superhasduper/ca-on-electromagnetico/README.md

# ca-on-electromagnetico
Este trabajo es para la asignatura de física Electromagnética, es el trabajo de el grupo HEM, en este trabajo se ha trabajado como iguales. Los miembros del equipo somos Erik Lesta Lopez, Hector Avila Sanchez y Michele Ambrosini.
los archivos pdf resumen todo al completo
