superhasduper/ca-on-electromagnetico/Arduino y CAD/arduino y CAD.pdf

## Código de Arduino y archivos CAD:

Para tener un producto final más pulido programamos la placa y los sensores en Arduino (el archivo utilizado para disparar en las pruebas fue el de test2.ino el cual no utiliza los sensores y solo manda una señal a los optoacopladores para disparar, el programa de velocidad proyectil si que emplea los sensores)
Además, diseñamos en 3d usando solidworks, soportes para los sensores y el proyectil. Todos los archivos se encuentran en su carpeta correspondiente.

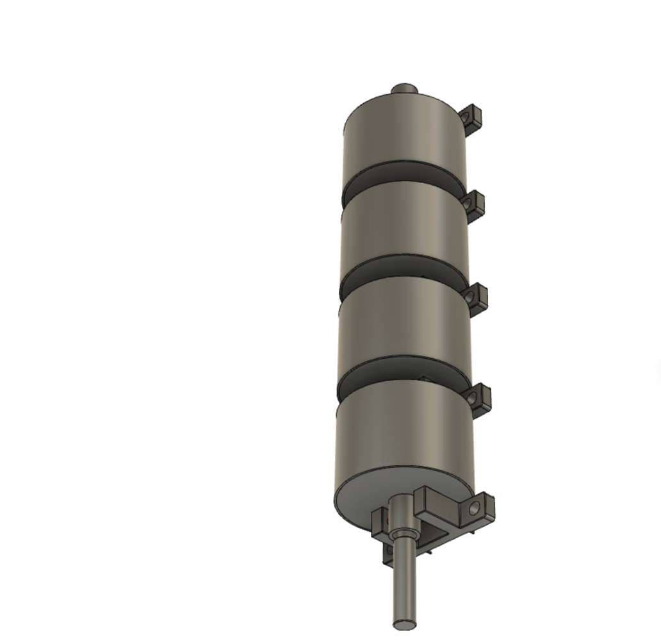
[picture p1: figure]

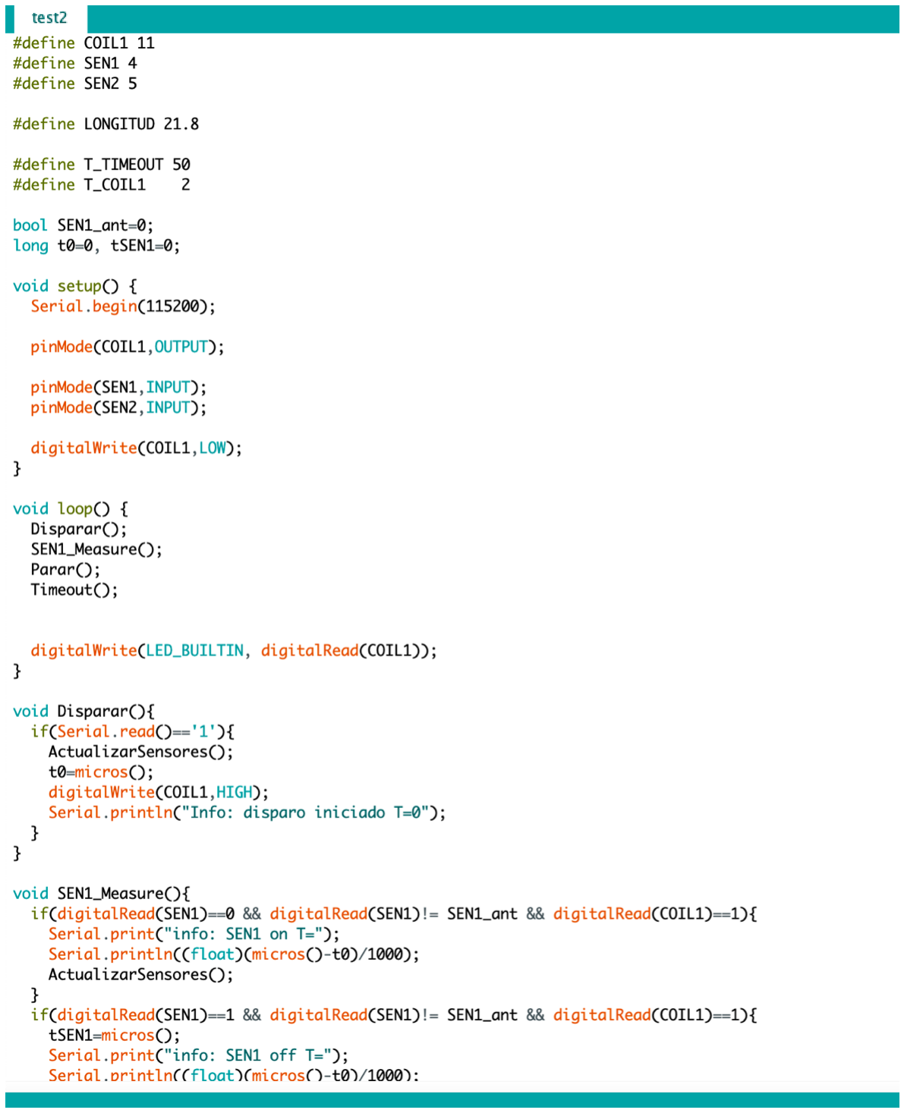
[picture p2: figure]
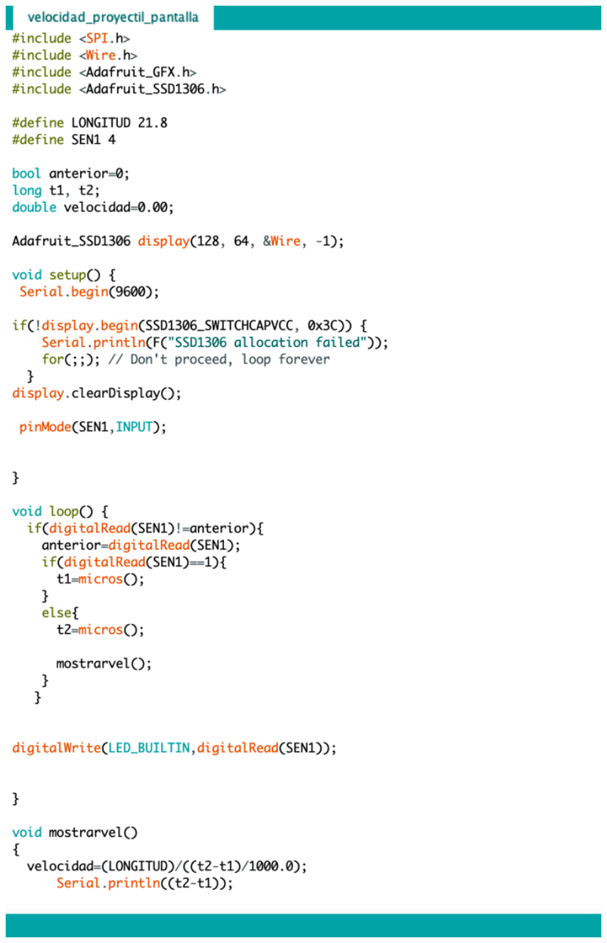
[picture p3: page 3]
