superhasduper/ca-on-electromagnetico/Cálculos y gráficas de simulaciones/Cálculo de velocidad del proyectil.pdf

Cálculo teórico de la velocidad de salida del proyectil

Si asumimos que la bobina que hemos utilizado para el cañón es “larga y estrecha”,

para calcular la velocidad del proyectil en el momento de salida, podemos computar

el cálculo de la inductancia de la misma, luego utilizar ese resultado para calcular el

trabajo (energía almacenada en la bobina) y finalmente, mediante la ley de

conservación de energía, relacionarlo con la velocidad de salida del proyectil:

Se puede probar que:

[1]

W =

1
2

⋅ L ⋅ i

2

Donde W es el trabajo realizado, L es la inductancia de la bobina, y i es la intensidad

de corriente.

Para calcular la inductancia L, y aceptando que se dispone de un solenoide ideal,

partimos del campo magnético de este:
B = μ0

⋅ n ⋅ i

Podemos calcular que el flujo en todo el solenoide será: φ = ∫B ⋅ dS =

S

μ0

⋅ n ⋅ i ⋅ S ⋅ N = μ0

⋅

N
l

⋅ i ⋅ S ⋅ N

Donde n =

número de vueltas
longitud bobina

=

N
l

, y S = superficie de sección transversal

Luego, se calculará la inductancia:

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
Sustituyendo [2] en [1]:

W =

1
2

⋅

μ0

⋅ N

2
⋅ S ⋅ i

2
l

(J)

Sustituyendo los datos calculados: μ0 = 4π ⋅ 10⁻⁷Wb/(A ⋅ m)

N = número de vueltas = 167
r = radio sección transveral = 5 ⋅ 10⁻³m

i = 5A
l = longitud bobina = 30 ⋅ 10⁻³m

W =

1
2

⋅

167²

⋅ π(5 ⋅ 10⁻³m)

2

⋅ 4π ⋅ 10⁻⁷ Wb
A ⋅ m

⋅ 5

2
30 ⋅ 10⁻³m

= 1.1469 ⋅ 10⁻³
J

Mediante la ley de conservación de energía y haciendo W = Em1
. Definimos el

momento (1) como un instante antes de que el proyectil sea expulsado de la bobina,

y el momento (2) como el instante en el que el proyectil es expulsado de la bobina.

Em1 + Ek1 = Em2 + Ek2

1.1469 J =

1
2

⋅ m ⋅ v

2

Sabiendo que m = masa proyectil = 3.6 ⋅ 10⁻³kg

v = √
2 ⋅ 1.1469 ⋅ 10⁻³ J
3.6 ⋅ 10⁻³kg = 0.7892 m/s
