superhasduper/ca-on-electromagnetico/Cálculos y gráficas de simulaciones/Gráficas de estadísticas recuperadas en simulaciones de rendimiento del cañón de bobina.pdf

- 1 -

Gráficas de estadísticas recuperadas en simulaciones de rendimiento del

cañón de bobina

Antes de acudir al laboratorio a probar el cañón, se le hicieron diferentes ensayos para medir

su rendimiento. En este documento se muestran los resultados que se obtuvieron mediante

gráficas.

Gráficos 1-11: Velocidad del proyectil en función del tiempo dentro de la bobina

Bobina sin carcasa metálica exterior

Alimentación por fuente de alimentación 10 A

En estos gráficos (titulados G:n en relación con el número de gráfico que se explica), se muestra

la velocidad (m/s) que se imprime en cada proyectil dependiendo del tiempo de simulación (ms)

(tiempo en el que el proyectil avanza cierta distancia dentro de la bobina). Se han analizado 11

proyectiles distintos, que varían desde 10mm hasta 20mm, con una diferencia de 1mm por

proyectil.

Resistencia: constante y de 0.41 ohm.

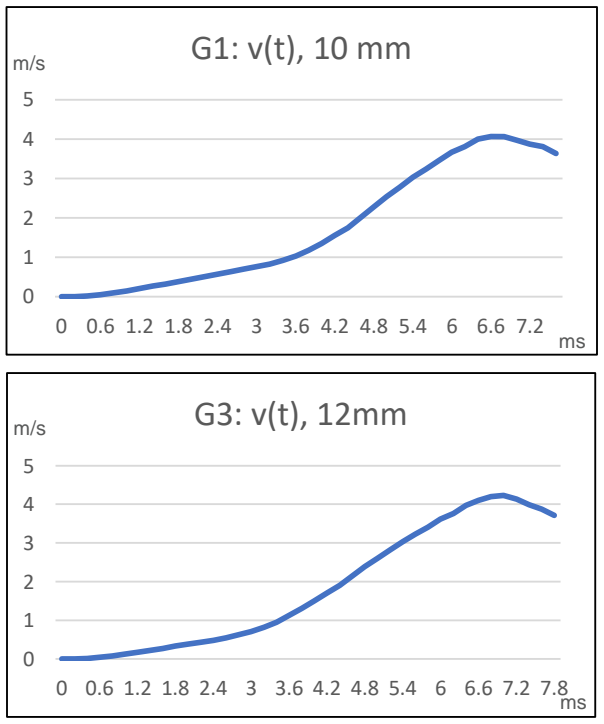
[picture p4: figure]

0 0.6 1.2 1.8 2.4 3 3.6 4.2 4.8 5.4 6 6.6 7.2

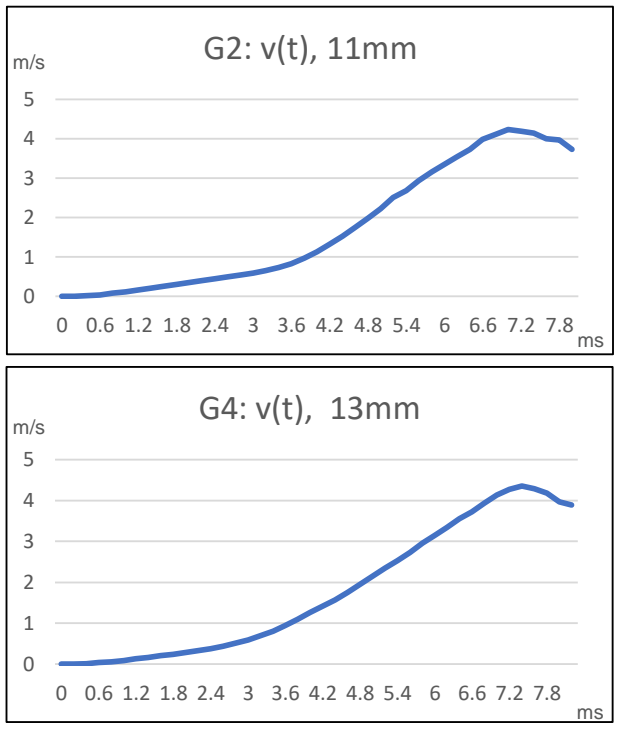
[picture p5: figure]

0 0.6 1.2 1.8 2.4 3 3.6 4.2 4.8 5.4 6 6.6 7.2 7.8

0 0.6 1.2 1.8 2.4 3 3.6 4.2 4.8 5.4 6 6.6 7.2 7.8 0 0.6 1.2 1.8 2.4 3 3.6 4.2 4.8 5.4 6 6.6 7.2 7.8

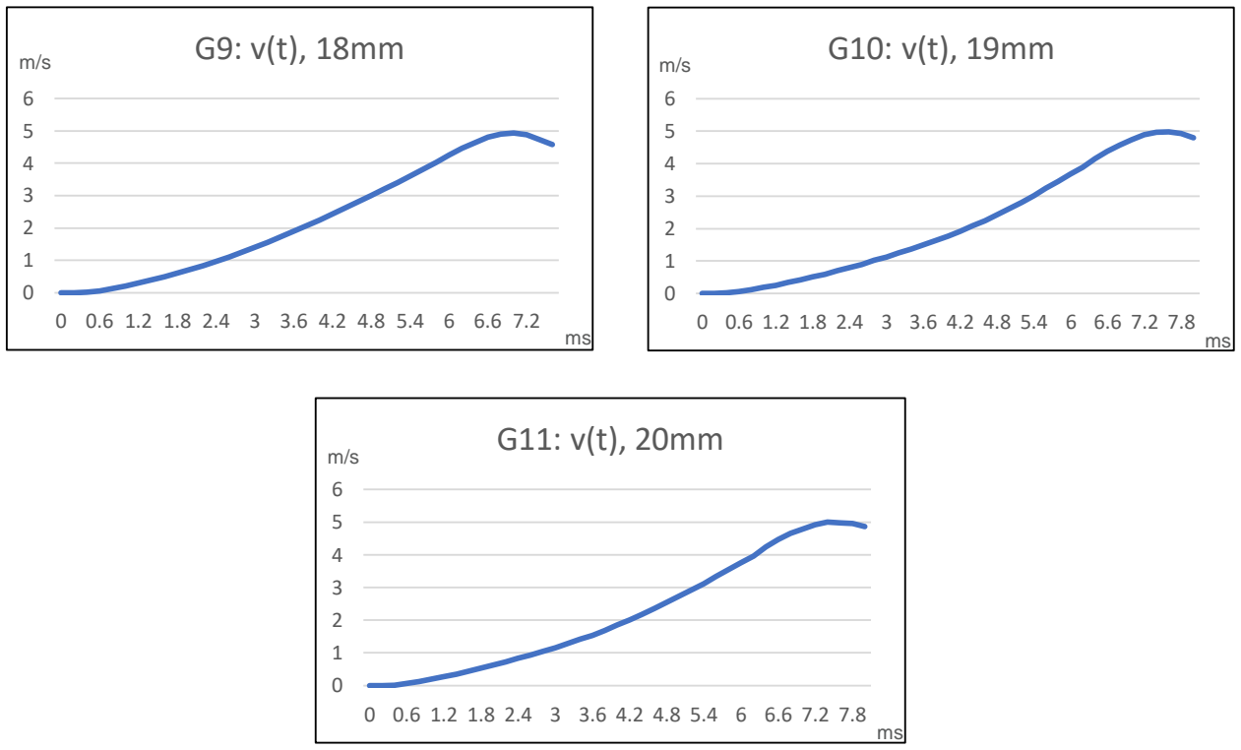
[picture p6: figure]

- 2 -

0

1

2

3

4

5

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

### G5: v(t), 14mm

0

1

2

3

4

5

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

### G6: v(t), 15mm

0

1

2

3

4

5

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

### G7: v(t), 16mm

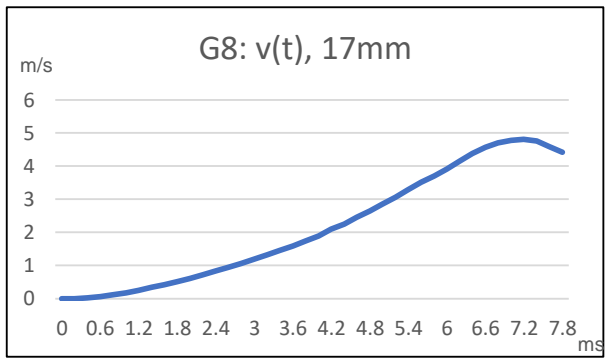
[picture p7: figure]

0 0.6 1.2 1.8 2.4 3 3.6 4.2 4.8 5.4 6 6.6 7.2 7.8

0 0.6 1.2 1.8 2.4 3 3.6 4.2 4.8 5.4 6 6.6 7.2 0 0.6 1.2 1.8 2.4 3 3.6 4.2 4.8 5.4 6 6.6 7.2 7.8

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

m/s

ms

m/s

ms

m/s

ms

- 3 -

Gráfico 12: Velocidad máxima del proyectil en función a su longitud (10mm-20mm)

Para este ensayo se analizaron los datos recopilados de los 11 proyectiles de diferentes

tamaños (de 10 a 20mm) para ver el impacto que esta variable tiene en los resultados de

velocidad máxima.

Sin carcasa al exterior.

Corriente que circuló por la bobina: 10 A.

Gráficos 13-23: Velocidad del proyectil en función del tiempo dentro de la bobina

Bobina con carcasa metálica exterior completa

Alimentada por batería 47.9 A

Para este ensayo, se ha medido la velocidad a la que avanza el proyectil (m/s) con respecto al

tiempo (ms).

Se ha colocado completamente la carcasa metálica al exterior de la bobina de manera que

cubre toda la bobina.

Resistencia: constante y de 0.22 ohm.

Corriente que circuló por la bobina: 47.9 A.

0

1

2

3

4

5

6

10 | 11 | 12 | 13 | 14 | 15 | 16 | 17 | 18 | 19 | 20

### Velocidad máxima (m/s) m/s

mm

- 4 -

0

2

4

6

8

10

12

0 0.40.81.21.6 2 2.42.83.23.6 4 4.44.85.25.6 6 6.4

### G13: v(t), 15mm

0

2

4

6

8

10

12

0 0.4 0.8 1.2 1.6 2 2.4 2.8 3.2 3.6 4 4.4

### G17: v(t), 19mm

0

2

4

6

8

10

12

0 0.4 0.8 1.2 1.6 2 2.4 2.8 3.2 3.6 4 4.4 4.8 5.2 5.6

### G14: v(t), 16mm

0

2

4

6

8

10

12

0 0.4 0.8 1.2 1.6 2 2.4 2.8 3.2 3.6 4 4.4 4.8 5.2

### G15: v(t), 17mm

0

5

10

15

0 0.4 0.8 1.2 1.6 2 2.4 2.8 3.2 3.6 4 4.4 4.8

### G16: v(t), 18mm

0

2

4

6

8

10

12

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

### G18: v(t), 20mm

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
- 5 -

0

2

4

6

8

10

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

### G21: v(t), 23mm

0

2

4

6

8

10

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

### G23: v(t), 25mm

0

2

4

6

8

10

12

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

### G19: v(t), 21mm

0

2

4

6

8

10

12

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

### G20: v(t), 22mm

0

2

4

6

8

10

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

m/s | G22: v(t), 24mm

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
- 6 -

Gráfico 24: Velocidad máxima del proyectil en función a su longitud (15mm-25mm)

Bobina con carcasa metálica exterior completa

Alimentada por batería

Para este ensayo se analizaron los datos recopilados de los 11 proyectiles de diferentes

tamaños (de 15 a 25mm) para ver el impacto que esta variable tiene en los resultados de

velocidad máxima.

Carcasa exterior de la bobina colocada completamente.

Corriente que circuló por la bobina: 47.9 A.

8

8.5

9

9.5

10

10.5

15 | 16 | 17 | 18 | 19 | 20 | 21 | 22 | 23 | 24 | 25
m/s | velocidad máxima

mm

- 7 -

Gráfico 25: Velocidad del proyectil en función del tiempo dentro de la bobina

Bobina sin carcasa metálica en el exterior

Alimentada por batería

Para este ensayo, se ha medido la velocidad a la que avanza el proyectil (m/s) con respecto al

tiempo (ms).

No se ha colocado la carcasa metálica al exterior de la bobina.

Velocidad máxima: 7.18 m/s.

Resistencia: constante y de 0.22 ohm.

Corriente que circuló por la bobina: 47.9 A.

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
0 0.2 0.4 0.6 0.8 1 1.2 1.4 1.6 1.8 2 2.2 2.4 2.6 2.8 3 3.2 3.4 3.6 3.8 4 4.2 4.4 4.6 4.8 5 5.2

### v(t) m/s

ms

- 8 -

Gráfico 26: Velocidad del proyectil en función del tiempo dentro de la bobina Bobina con carcasa metálica en los laterales

Alimentada por batería

Para este ensayo, se ha medido la velocidad a la que avanza el proyectil (m/s) con respecto al

tiempo (ms).

Se ha colocado parcialmente la carcasa metálica al exterior de la bobina de manera que cubre

solamente los laterales.

Velocidad máxima: 8.19 m/s.

Resistencia: constante y de 0.22 ohm.

Corriente que circuló por la bobina: 47.9 A.

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
0 0.2 0.4 0.6 0.8 1 1.2 1.4 1.6 1.8 2 2.2 2.4 2.6 2.8 3 3.2 3.4 3.6 3.8 4 4.2 4.4 4.6 4.8 5 5.2

### v(t) m/s

ms

- 9 -

Gráfico 27: Velocidad del proyectil en función del tiempo dentro de la bobina

Bobina con carcasa metálica completa

Alimentada por batería

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

tiempo (ms).

Se ha colocado completamente la carcasa metálica al exterior de la bobina.

Velocidad máxima: 9.36 m/s.

Resistencia: constante y de 0.22 ohm.

Corriente que circuló por la bobina: 47.9 A.

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
0 0.2 0.4 0.6 0.8 1 1.2 1.4 1.6 1.8 2 2.2 2.4 2.6 2.8 3 3.2 3.4 3.6 3.8 4 4.2 4.4 4.6

### v(t) m/s

ms

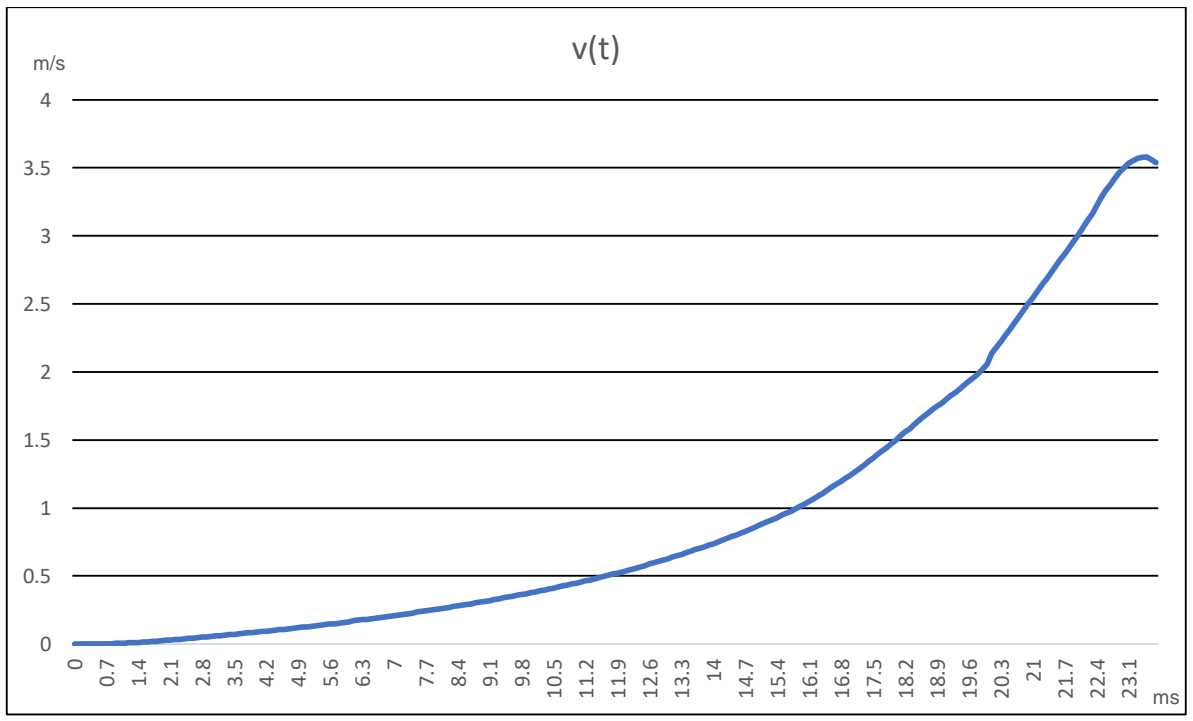
[picture p8: figure]

- 10 -

Gráfico 28: Velocidad del proyectil en función del tiempo dentro de la bobina

Bobina con carcasa metálica completa

Alimentada por fuente de alimentación 10 A

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

tiempo (ms).

Se ha colocado completamente la carcasa metálica al exterior de la bobina.

Velocidad máxima: 3.58 m/s.

Resistencia: constante y de 0.22 ohm.

Corriente que circuló por la bobina: 10 A.

Longitud del proyectil: de 23 mm.

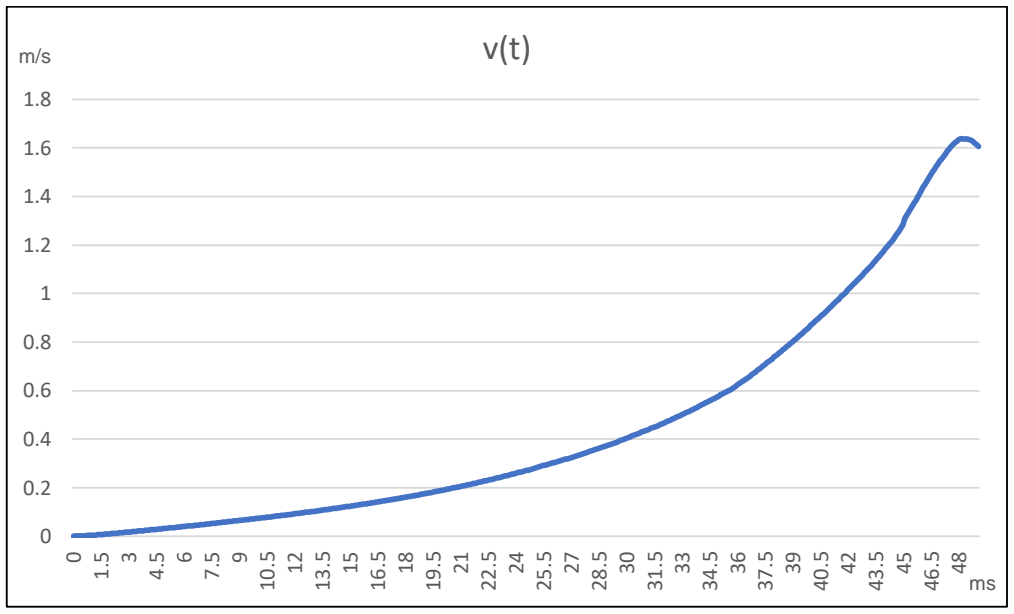
[picture p9: figure]

- 11 -

Gráfico 29: Velocidad del proyectil en función del tiempo dentro de la bobina

Bobina con carcasa metálica en los laterales

Alimentada por fuente de alimentación 5 A

Con coeficiente de fricción

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

tiempo (ms).

Se ha colocado parcialmente la carcasa metálica al exterior de la bobina de manera que cubre

solamente los laterales.

Velocidad máxima: 1.64 m/s.

Resistencia: constante y de 0.22 ohm.

Ha intervenido un coeficiente de fricción estático μe = 0.946, y un coeficiente de fricción

cinético μk = 0.364.

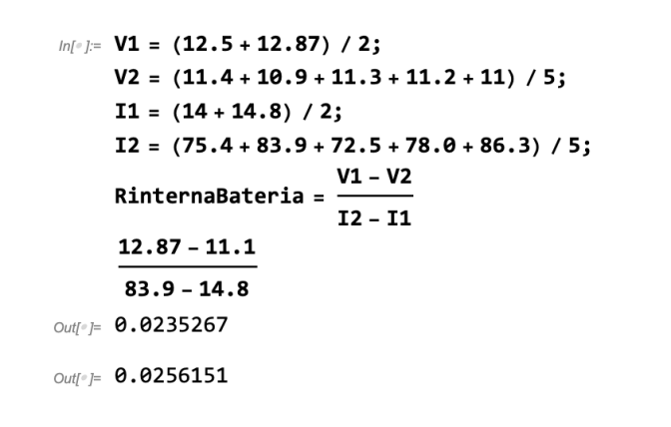
[picture p10: figure]
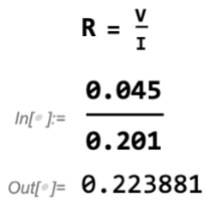
[picture p11: figure]

- 12 -

Cálculos de mediciones para bobina alimentada por batería a 10 A.

Resistencia interna de la batería

Para calcular la resistencia interna de la batería se midió la tensión y la corriente que salió de

la batería mientras se encontraba conectada a dos cargas con distinto consumo. Luego se

aplicó la siguiente formula:

Resistencia de la bobina

Una vez construida la bobina, calculamos de la siguiente manera su resistencia real. Para ello,

se hizo circular una corriente constante por la bobina y se midió la caída de tensión en la misma.
