superhasduper/ca-on-electromagnetico/Arduino y CAD/archivos 3d cañon/Coilgun.SLDASM

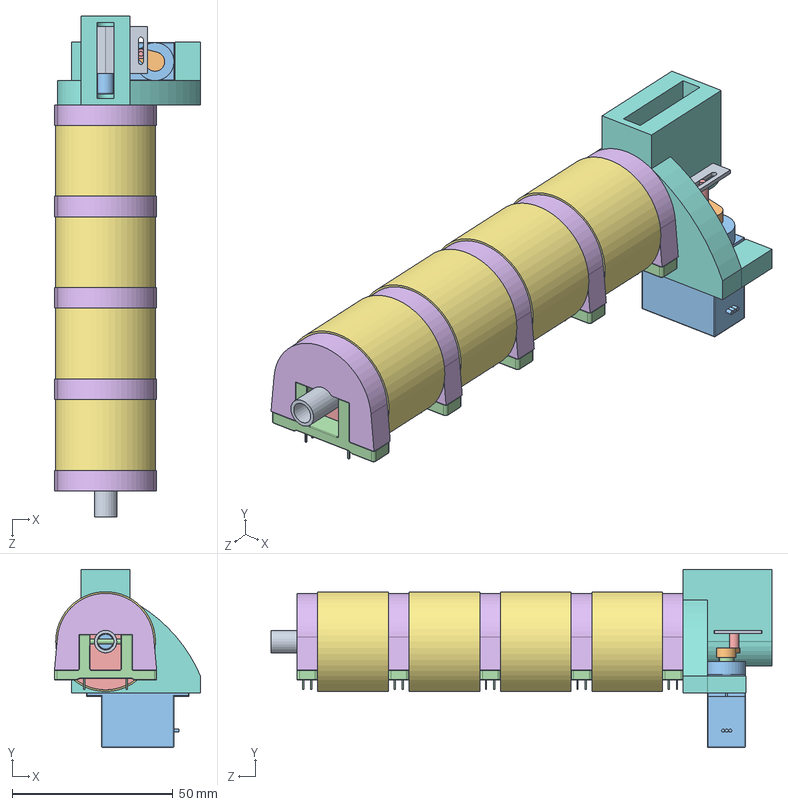
[picture p13: CAD file, 2022-06-12]
Arduino y CAD/archivos 3d cañon/Coilgun.SLDASM
45.4 x 55.3 x 155.5 mm
Tubo
Bobina x 4
Proyectil
Interruptor fotoelectrico x 5
Sporte bobina x 8
Soprte sensor medio x 5
Cilindro acero x 4
Cargador
Separador cargador
eje servo
axis.step
Empujador servo
