superhasduper/ca-on-electromagnetico/Arduino y CAD/archivos 3d cañon/sg90-micro-servomotor-1.snapshot.2/Cargador.SLDASM

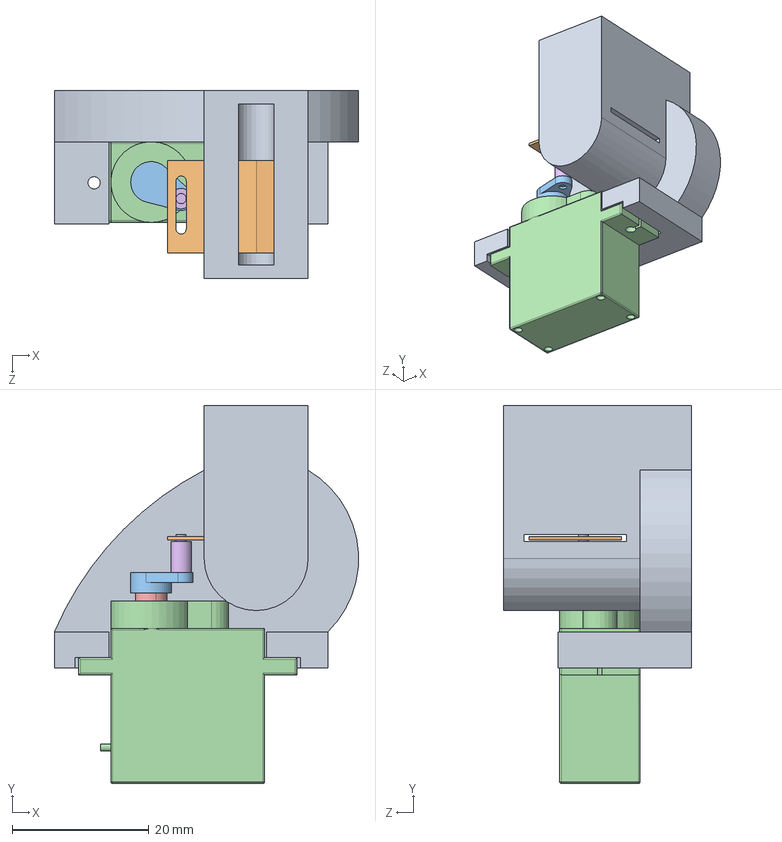
[picture p14: CAD file, 2022-06-12]
Arduino y CAD/archivos 3d cañon/sg90-micro-servomotor-1.snapshot.2/Cargador.SLDASM
44.5 x 55.3 x 27.5 mm
Cargador
Separador cargador
eje servo
axis.step
Empujador servo
