superhasduper/ca-on-electromagnetico/Arduino y CAD/archivos 3d cañon/Soporte sensor/Soprte sensor.SLDASM

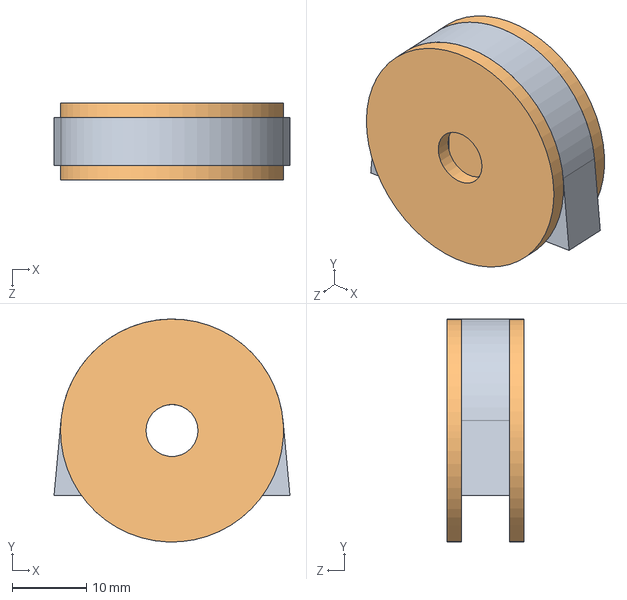
[picture p15: CAD file, 2022-06-12]
Arduino y CAD/archivos 3d cañon/Soporte sensor/Soprte sensor.SLDASM
31.8 x 30.0 x 10.4 mm
Soprte sensor medio
Soprte sensor lateral x 2
