superhasduper/ca-on-electromagnetico/Arduino y CAD/archivos 3d cañon/Soporte sensor/Soporte medio.dxf

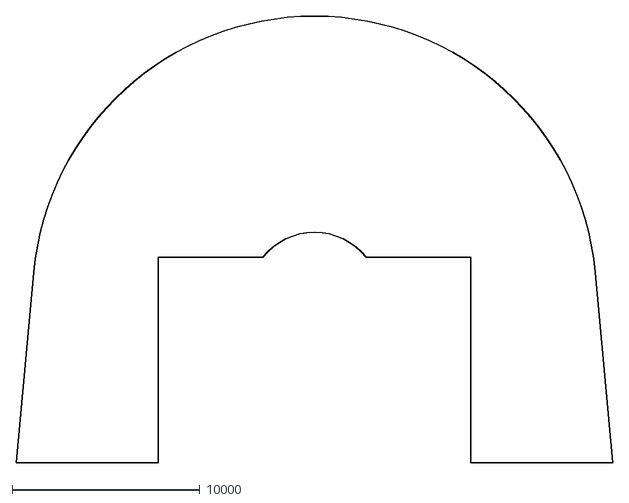
[picture p16: CAD file, 2022-06-12]
Arduino y CAD/archivos 3d cañon/Soporte sensor/Soporte medio.dxf
31750.0 x 23770.0
