superhasduper/ca-on-electromagnetico/PCB/POT.STEP

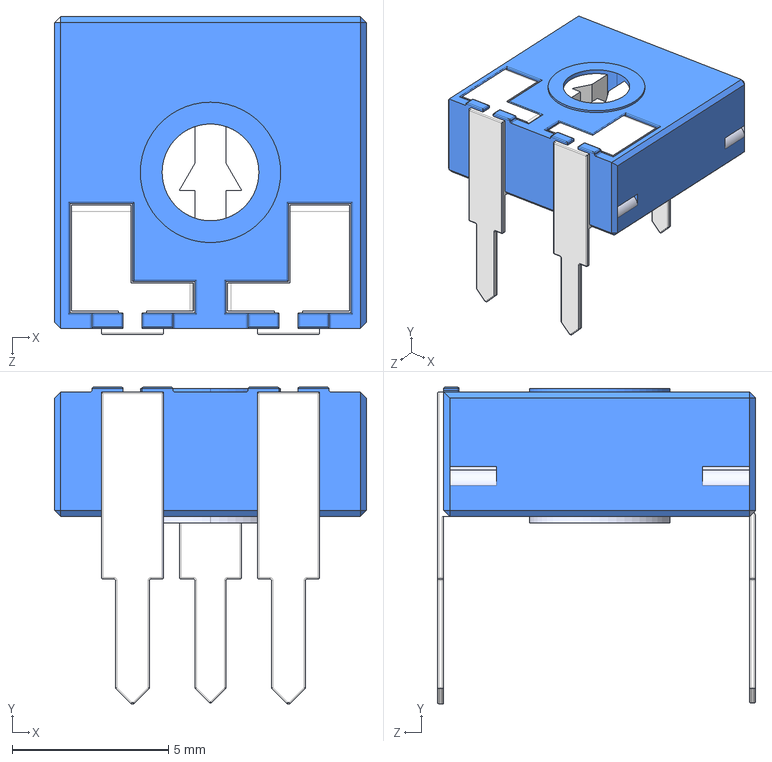
[picture p17: CAD file, 2022-06-12]
PCB/POT.STEP
10.0 x 10.1 x 10.2 mm
