superhasduper/ca-on-electromagnetico/Arduino y CAD/archivos 3d cañon/sg90-micro-servomotor-1.snapshot.2/Part2.SLDPRT

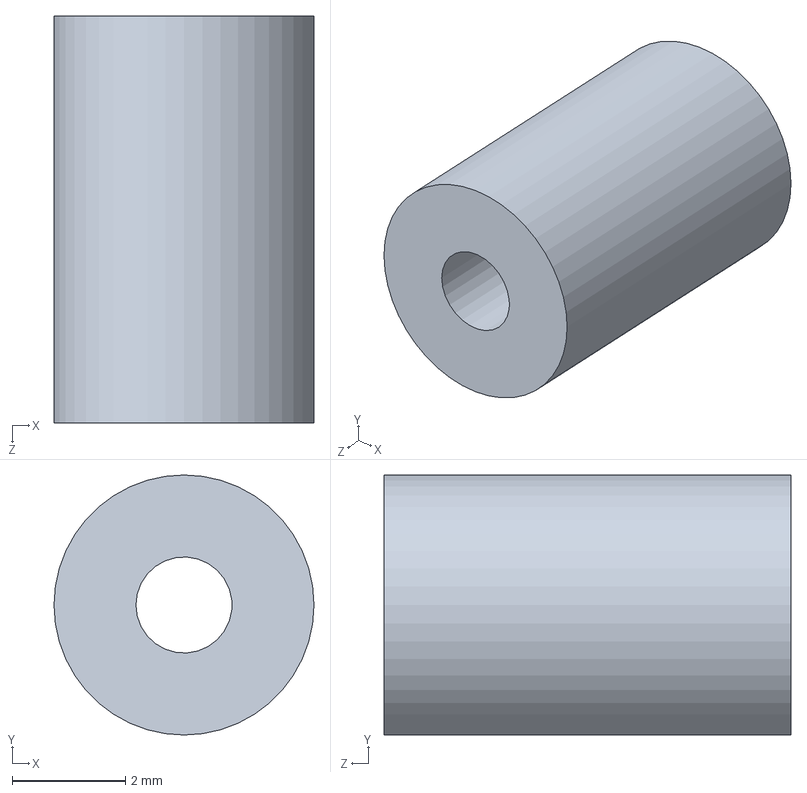
[picture p18: CAD file, 2022-06-12]
Arduino y CAD/archivos 3d cañon/sg90-micro-servomotor-1.snapshot.2/Part2.SLDPRT
4.60 x 4.60 x 7.20 mm
