superhasduper/ca-on-electromagnetico/Arduino y CAD/archivos 3d cañon/Soporte sensor/Soprte sensor medio.SLDPRT

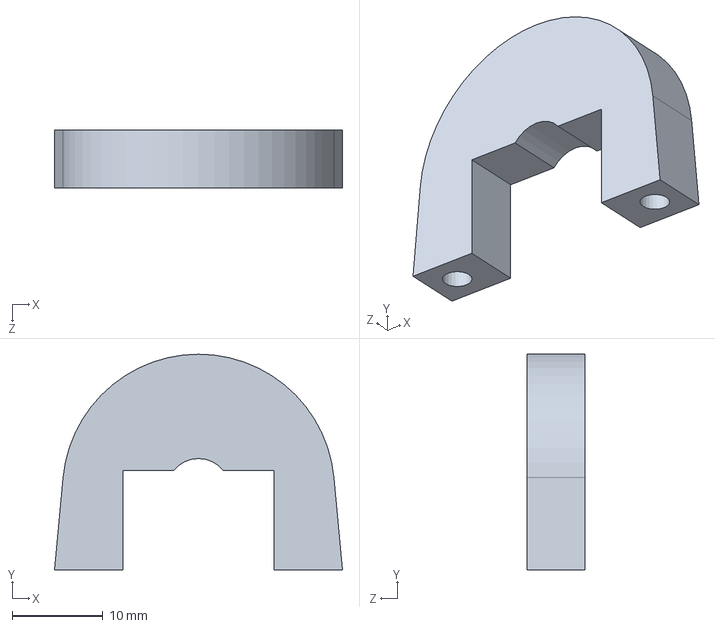
[picture p19: CAD file, 2022-06-12]
Arduino y CAD/archivos 3d cañon/Soporte sensor/Soprte sensor medio.SLDPRT
31.8 x 23.8 x 6.40 mm
