superhasduper/ca-on-electromagnetico/Arduino y CAD/archivos 3d cañon/Sporte bobina.SLDPRT

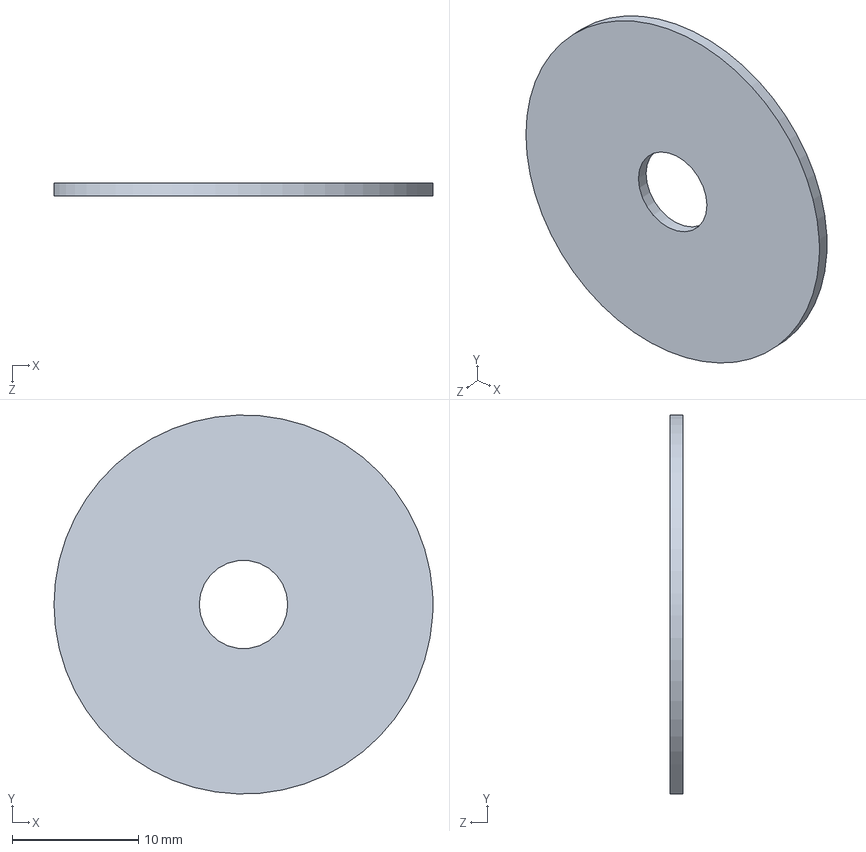
[picture p20: CAD file, 2022-06-12]
Arduino y CAD/archivos 3d cañon/Sporte bobina.SLDPRT
30.0 x 30.0 x 1.00 mm
