superhasduper/ca-on-electromagnetico/Arduino y CAD/archivos 3d cañon/Cilindro acero.SLDPRT

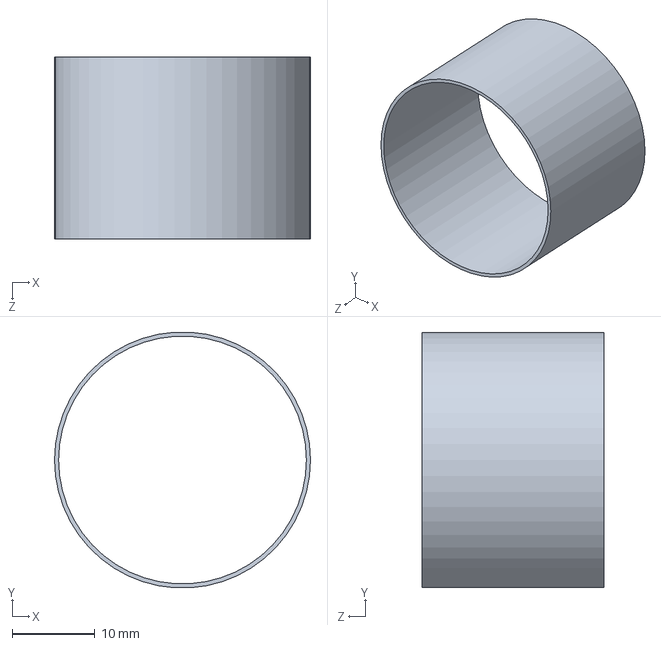
[picture p21: CAD file, 2022-06-12]
Arduino y CAD/archivos 3d cañon/Cilindro acero.SLDPRT
31.0 x 30.9 x 22.0 mm
