superhasduper/ca-on-electromagnetico/Arduino y CAD/archivos 3d cañon/sg90-micro-servomotor-1.snapshot.2/Part1.SLDPRT

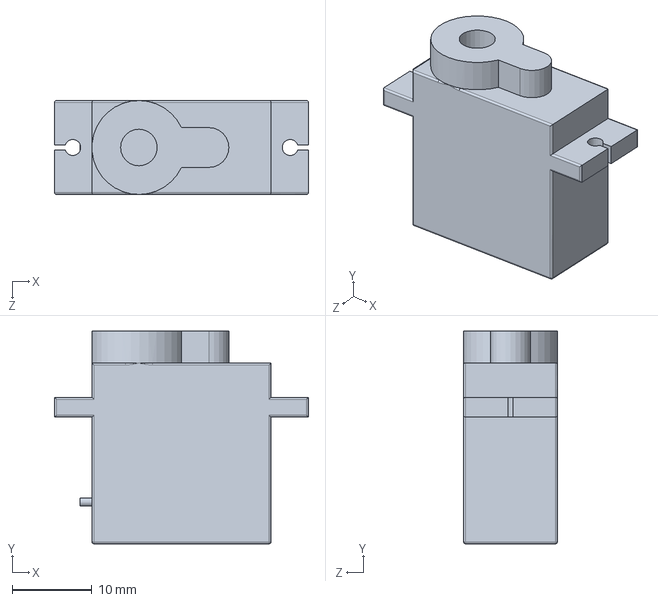
[picture p22: CAD file, 2022-06-12]
Arduino y CAD/archivos 3d cañon/sg90-micro-servomotor-1.snapshot.2/Part1.SLDPRT
31.9 x 26.7 x 11.8 mm
