superhasduper/ca-on-electromagnetico/Arduino y CAD/archivos 3d cañon/Soporte sensor/Soprte lateral.dxf

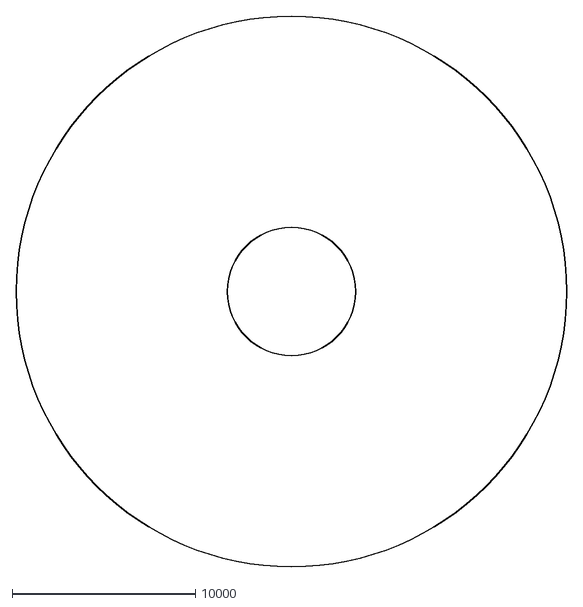
[picture p23: CAD file, 2022-06-12]
Arduino y CAD/archivos 3d cañon/Soporte sensor/Soprte lateral.dxf
30000.0 x 30000.0
