superhasduper/ca-on-electromagnetico/Arduino y CAD/archivos 3d cañon/Interruptor fotoelectrico.SLDPRT

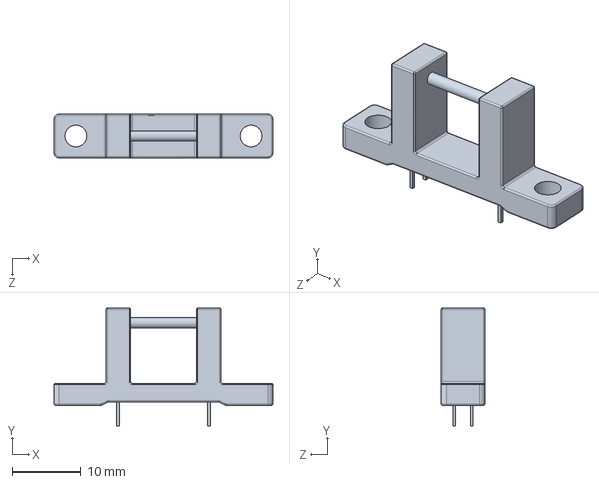
[picture p24: CAD file, 2022-06-12]
Arduino y CAD/archivos 3d cañon/Interruptor fotoelectrico.SLDPRT
31.8 x 17.1 x 6.35 mm
