superhasduper/ca-on-electromagnetico/Arduino y CAD/archivos 3d cañon/Bobina.SLDPRT

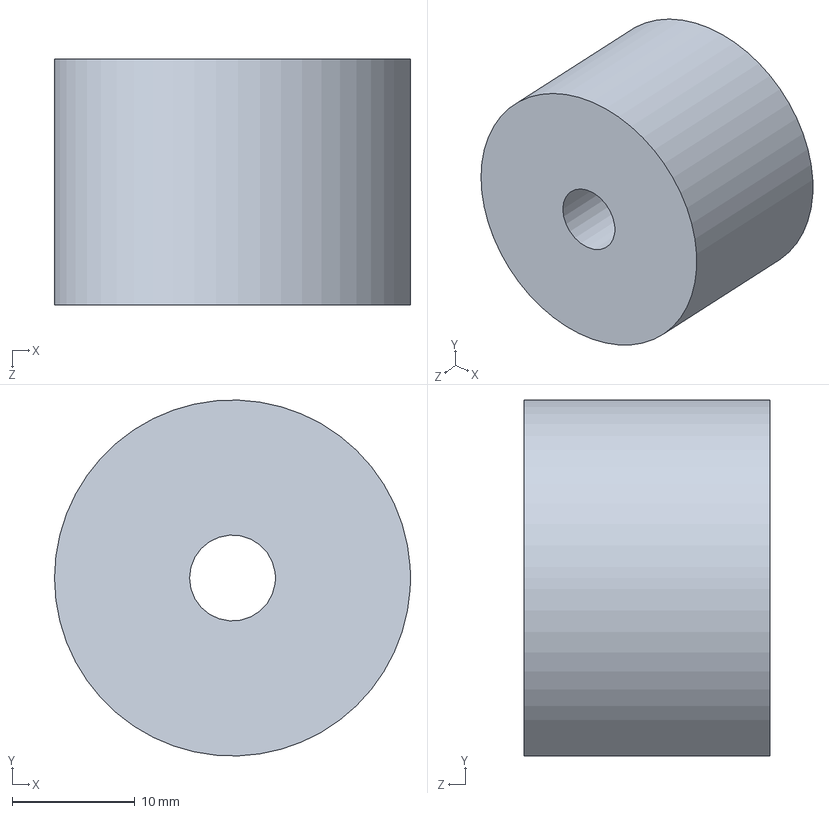
[picture p25: CAD file, 2022-06-12]
Arduino y CAD/archivos 3d cañon/Bobina.SLDPRT
29.0 x 29.0 x 20.0 mm
