superhasduper/ca-on-electromagnetico/Arduino y CAD/archivos 3d cañon/sg90-micro-servomotor-1.snapshot.2/eje servo.SLDPRT

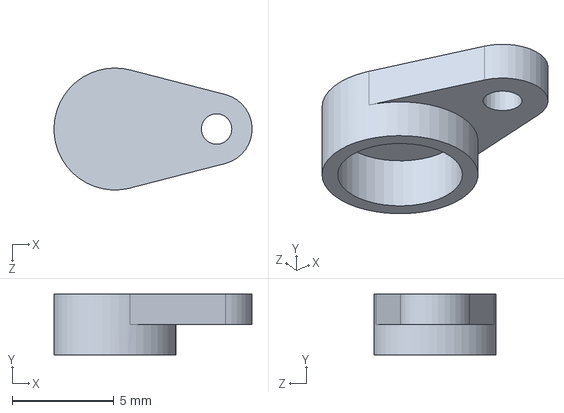
[picture p26: CAD file, 2022-06-12]
Arduino y CAD/archivos 3d cañon/sg90-micro-servomotor-1.snapshot.2/eje servo.SLDPRT
9.74 x 3.00 x 6.00 mm
