superhasduper/ca-on-electromagnetico/Arduino y CAD/archivos 3d cañon/Soporte sensor/Soprte sensor lateral.SLDPRT

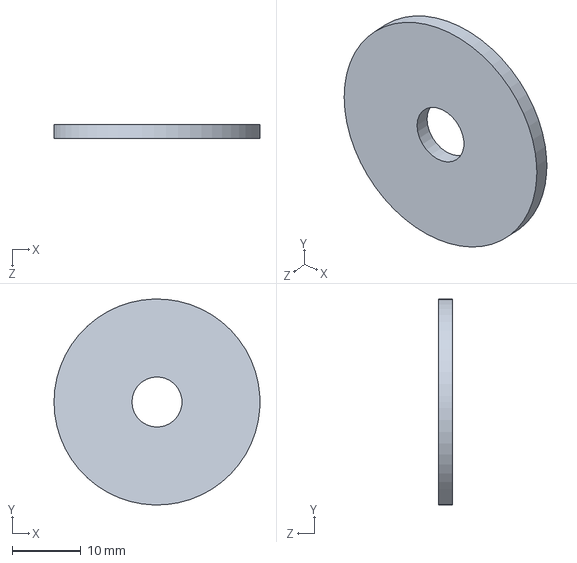
[picture p27: CAD file, 2022-06-12]
Arduino y CAD/archivos 3d cañon/Soporte sensor/Soprte sensor lateral.SLDPRT
30.0 x 30.0 x 2.00 mm
