superhasduper/ca-on-electromagnetico/Arduino y CAD/archivos 3d cañon/Proyectil.SLDPRT

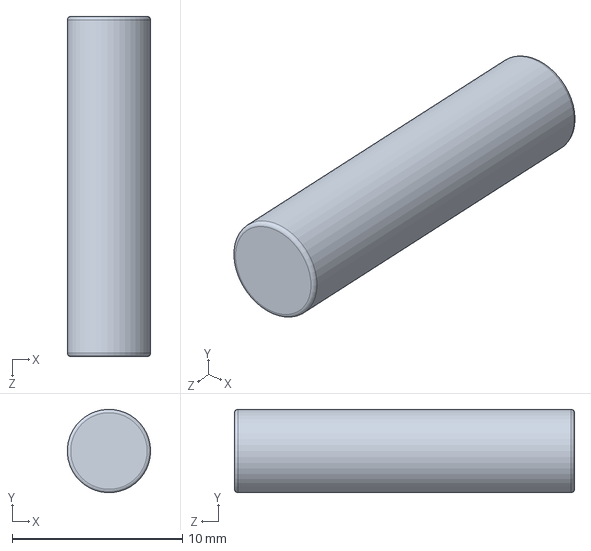
[picture p28: CAD file, 2022-06-12]
Arduino y CAD/archivos 3d cañon/Proyectil.SLDPRT
4.89 x 4.90 x 20.0 mm
