superhasduper/ca-on-electromagnetico/Arduino y CAD/archivos 3d cañon/sg90-micro-servomotor-1.snapshot.2/Separador cargador.SLDPRT

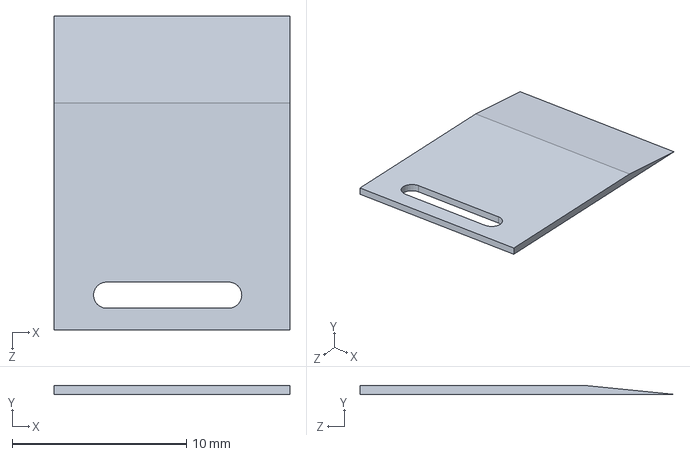
[picture p29: CAD file, 2022-06-12]
Arduino y CAD/archivos 3d cañon/sg90-micro-servomotor-1.snapshot.2/Separador cargador.SLDPRT
13.5 x 0.5 x 18.0 mm
