superhasduper/ca-on-electromagnetico/Arduino y CAD/archivos 3d cañon/Tubo.SLDPRT

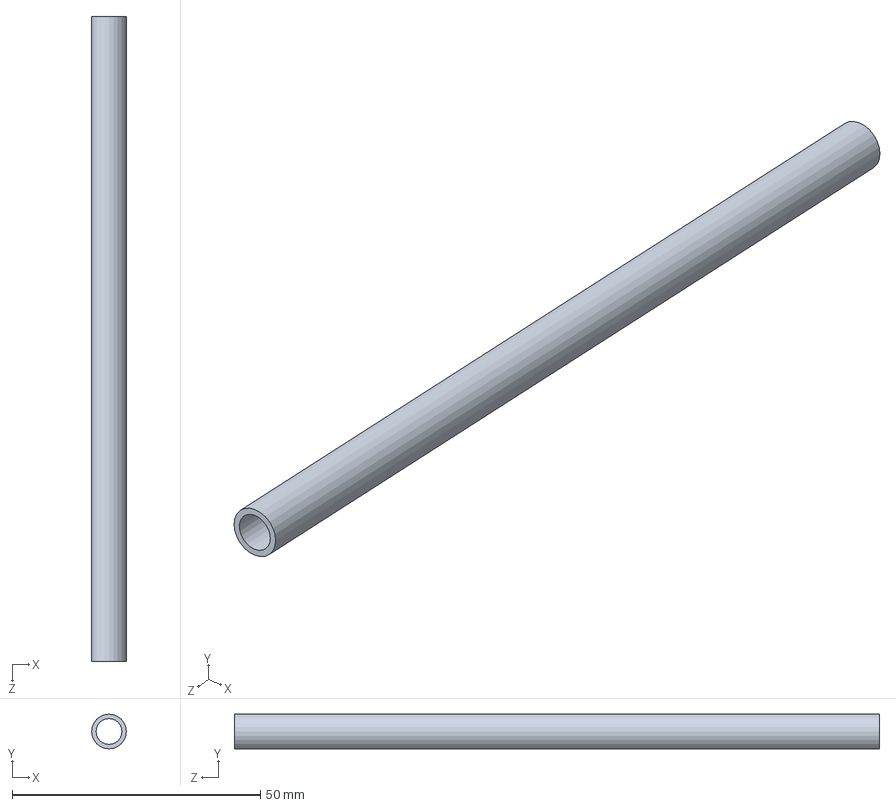
[picture p30: CAD file, 2022-06-12]
Arduino y CAD/archivos 3d cañon/Tubo.SLDPRT
7.00 x 7.00 x 130.0 mm
