superhasduper/ca-on-electromagnetico/Arduino y CAD/archivos 3d cañon/sg90-micro-servomotor-1.snapshot.2/sg90 micro servo.STEP

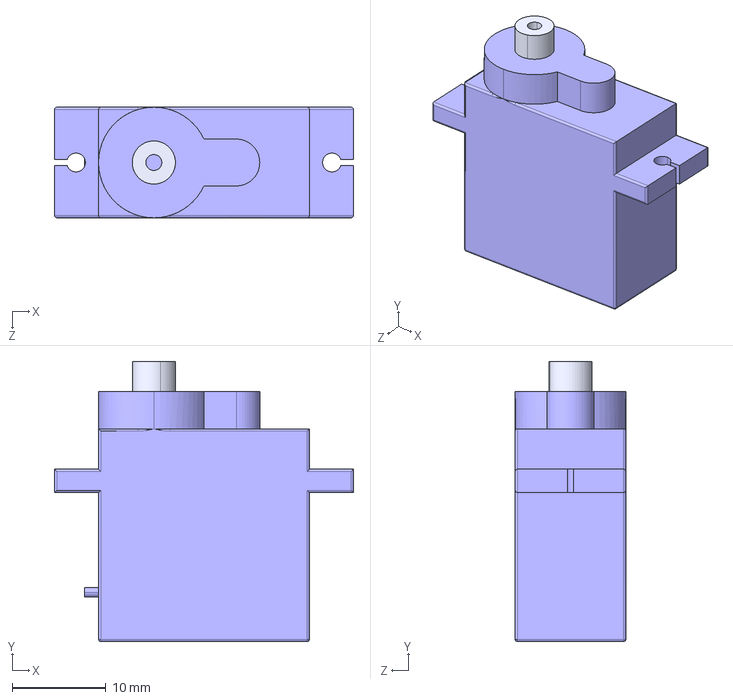
[picture p31: CAD file, 2022-06-12]
Arduino y CAD/archivos 3d cañon/sg90-micro-servomotor-1.snapshot.2/sg90 micro servo.STEP
31.9 x 29.9 x 11.8 mm
axis.step
