superhasduper/ca-on-electromagnetico/Arduino y CAD/archivos 3d cañon/sg90-micro-servomotor-1.snapshot.2/Empujador servo.SLDPRT

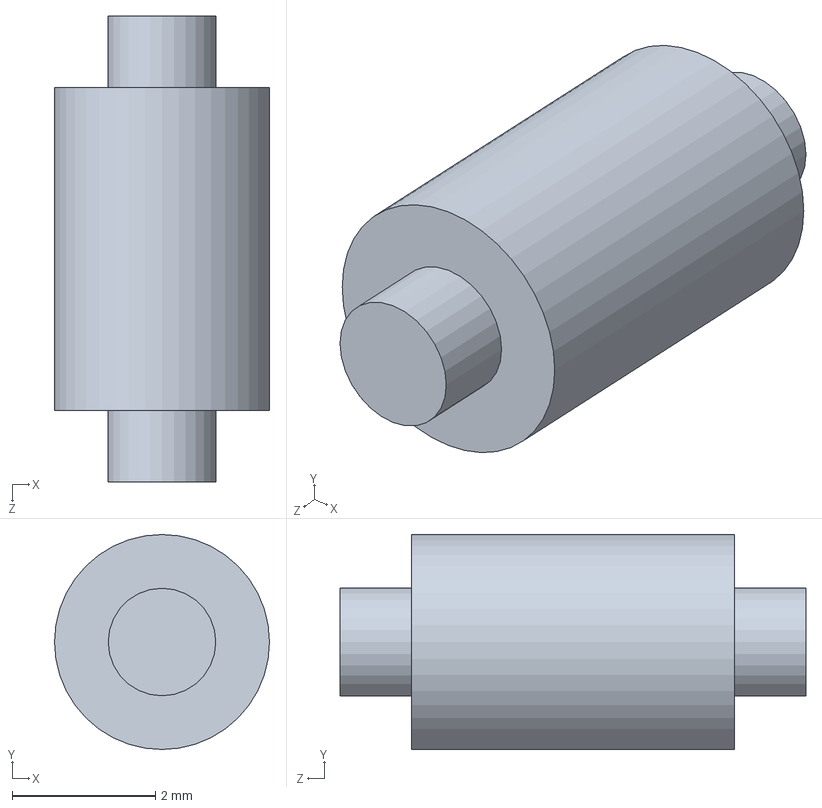
[picture p32: CAD file, 2022-06-12]
Arduino y CAD/archivos 3d cañon/sg90-micro-servomotor-1.snapshot.2/Empujador servo.SLDPRT
3.00 x 3.00 x 6.50 mm
