superhasduper/ca-on-electromagnetico/(list of files, cad)

Other CAD files:
Arduino y CAD/archivos 3d cañon/sg90-micro-servomotor-1.snapshot.2/body.STEP
Arduino y CAD/archivos 3d cañon/sg90-micro-servomotor-1.snapshot.2/axis.STEP
Arduino y CAD/archivos 3d cañon/Soporte sensor/Soprte sensor lateral.STL
Arduino y CAD/archivos 3d cañon/Soporte sensor/Soprte sensor medio.STL
Arduino y CAD/archivos 3d cañon/sg90-micro-servomotor-1.snapshot.2/Cargador.SLDPRT
Arduino y CAD/archivos 3d cañon/sg90-micro-servomotor-1.snapshot.2/Cargador.STL
Arduino y CAD/archivos 3d cañon/sg90-micro-servomotor-1.snapshot.2/Separador cargador.STL
Arduino y CAD/archivos 3d cañon/sg90-micro-servomotor-1.snapshot.2/sg90 micro servo.SLDASM
PCB/Project Outputs for Free Documents/CAM/OldVersions/Part1.0001.ipt
PCB/Project Outputs for Free Documents/CAM/Part1.ipt
