superhasduper/ca-on-electromagnetico/recursos obtenidos de las investigaciones realizadas/Untitled Notebook.pdf

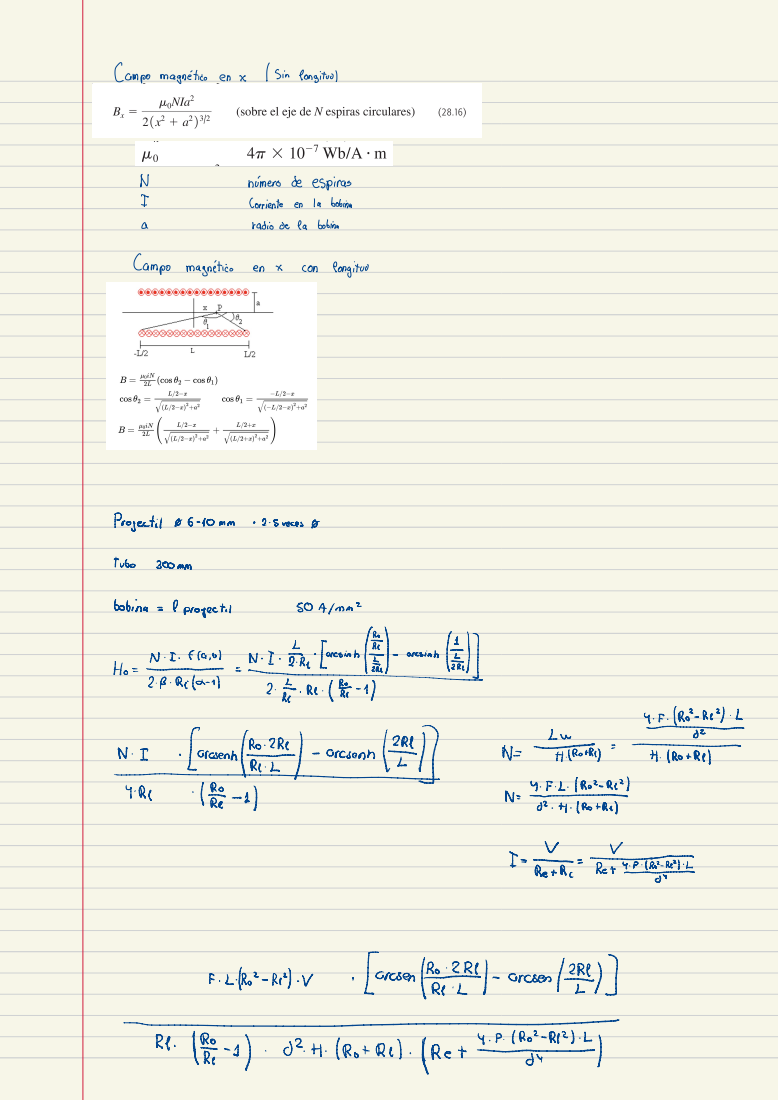
[picture p33: page 2]
Campo magnético en; / sin longitud; número de espiras; Corriente en; la bobina; radio de la bobina; Campo magnético; con; longitud; Proyectil 06 -10mm; 2-5 veces; tubo; bobina =; proyectil; Ritu

I.it?:::!;:-l-....n*Bn=::.:.i:::YI--pE-- ÍÜÜ
arosenffje.IT/-arcsen/2I-))#--).d.I-R.Re-F--
