superhasduper/ca-on-electromagnetico/PCB/Esquemas pcb.pdf

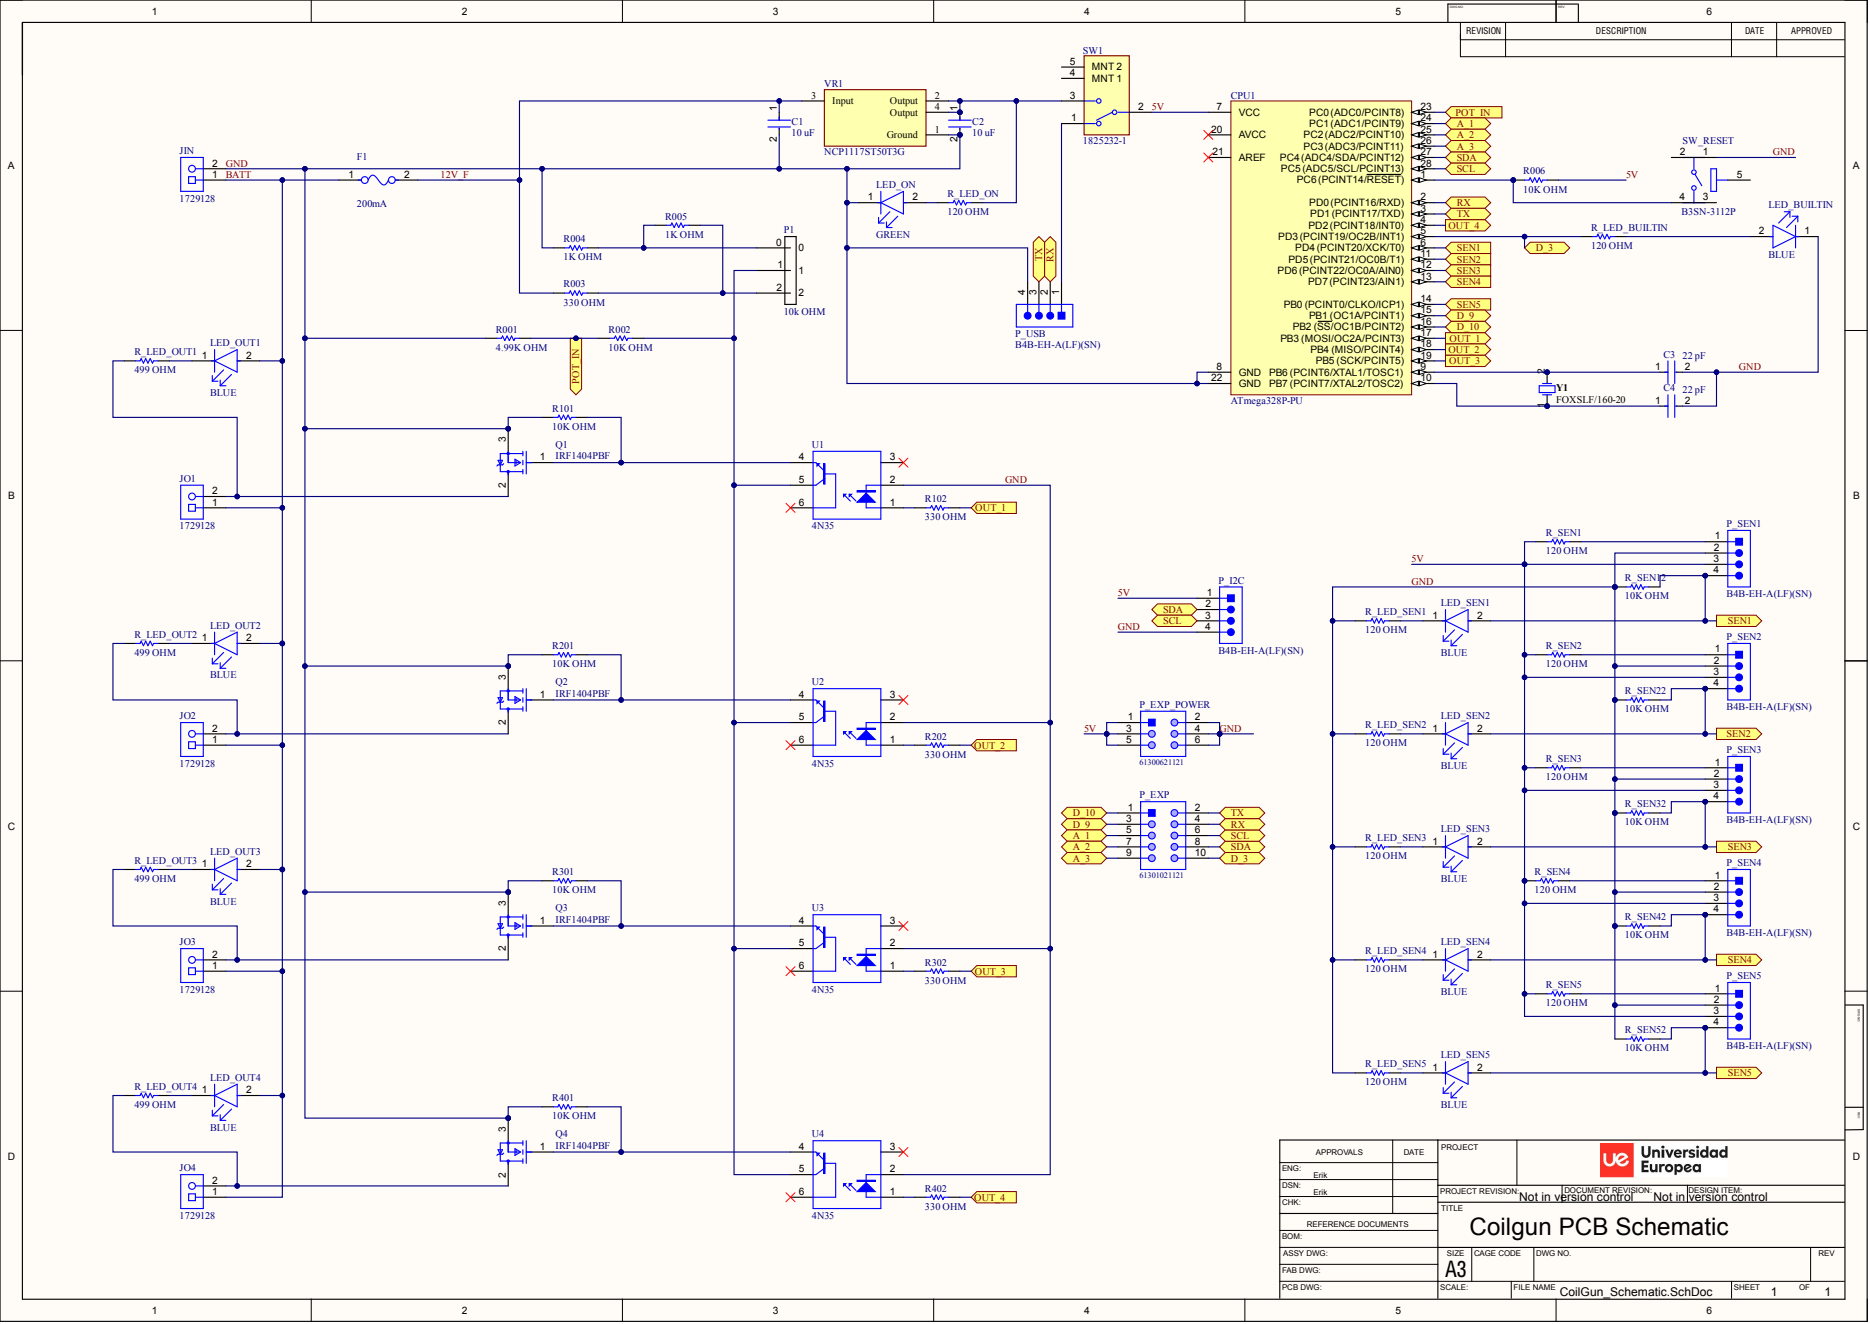
[picture p34: page 1]

DWG NO: | REV:

Output 2 3 Output 4 | REVISION | DESCRIPTION | DATE | APPROVED

DATE | PROJECT APPROVALS

ENG: Erik

DSN: Erik

CHK:

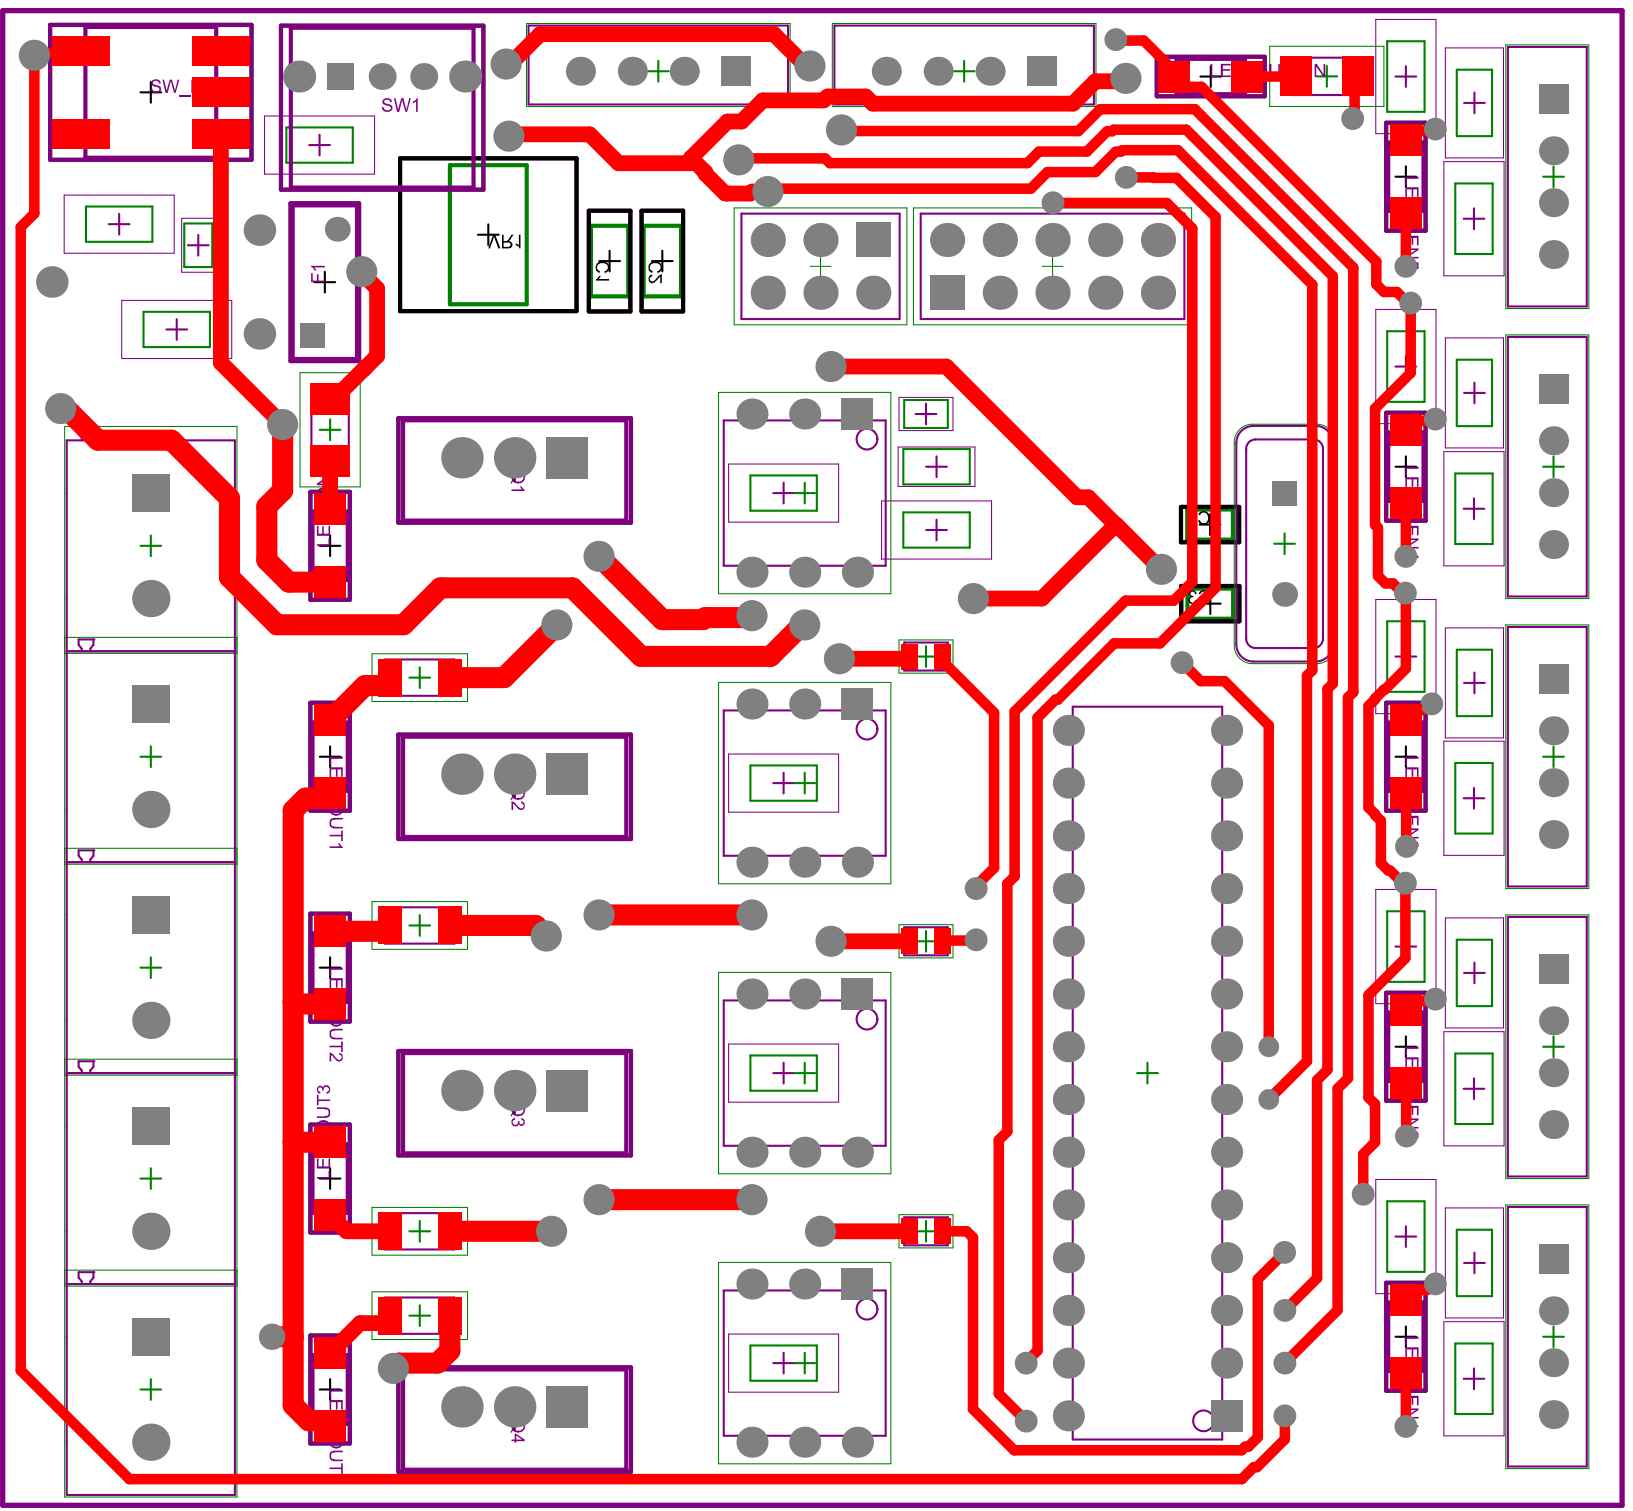
[picture p35: page 2]

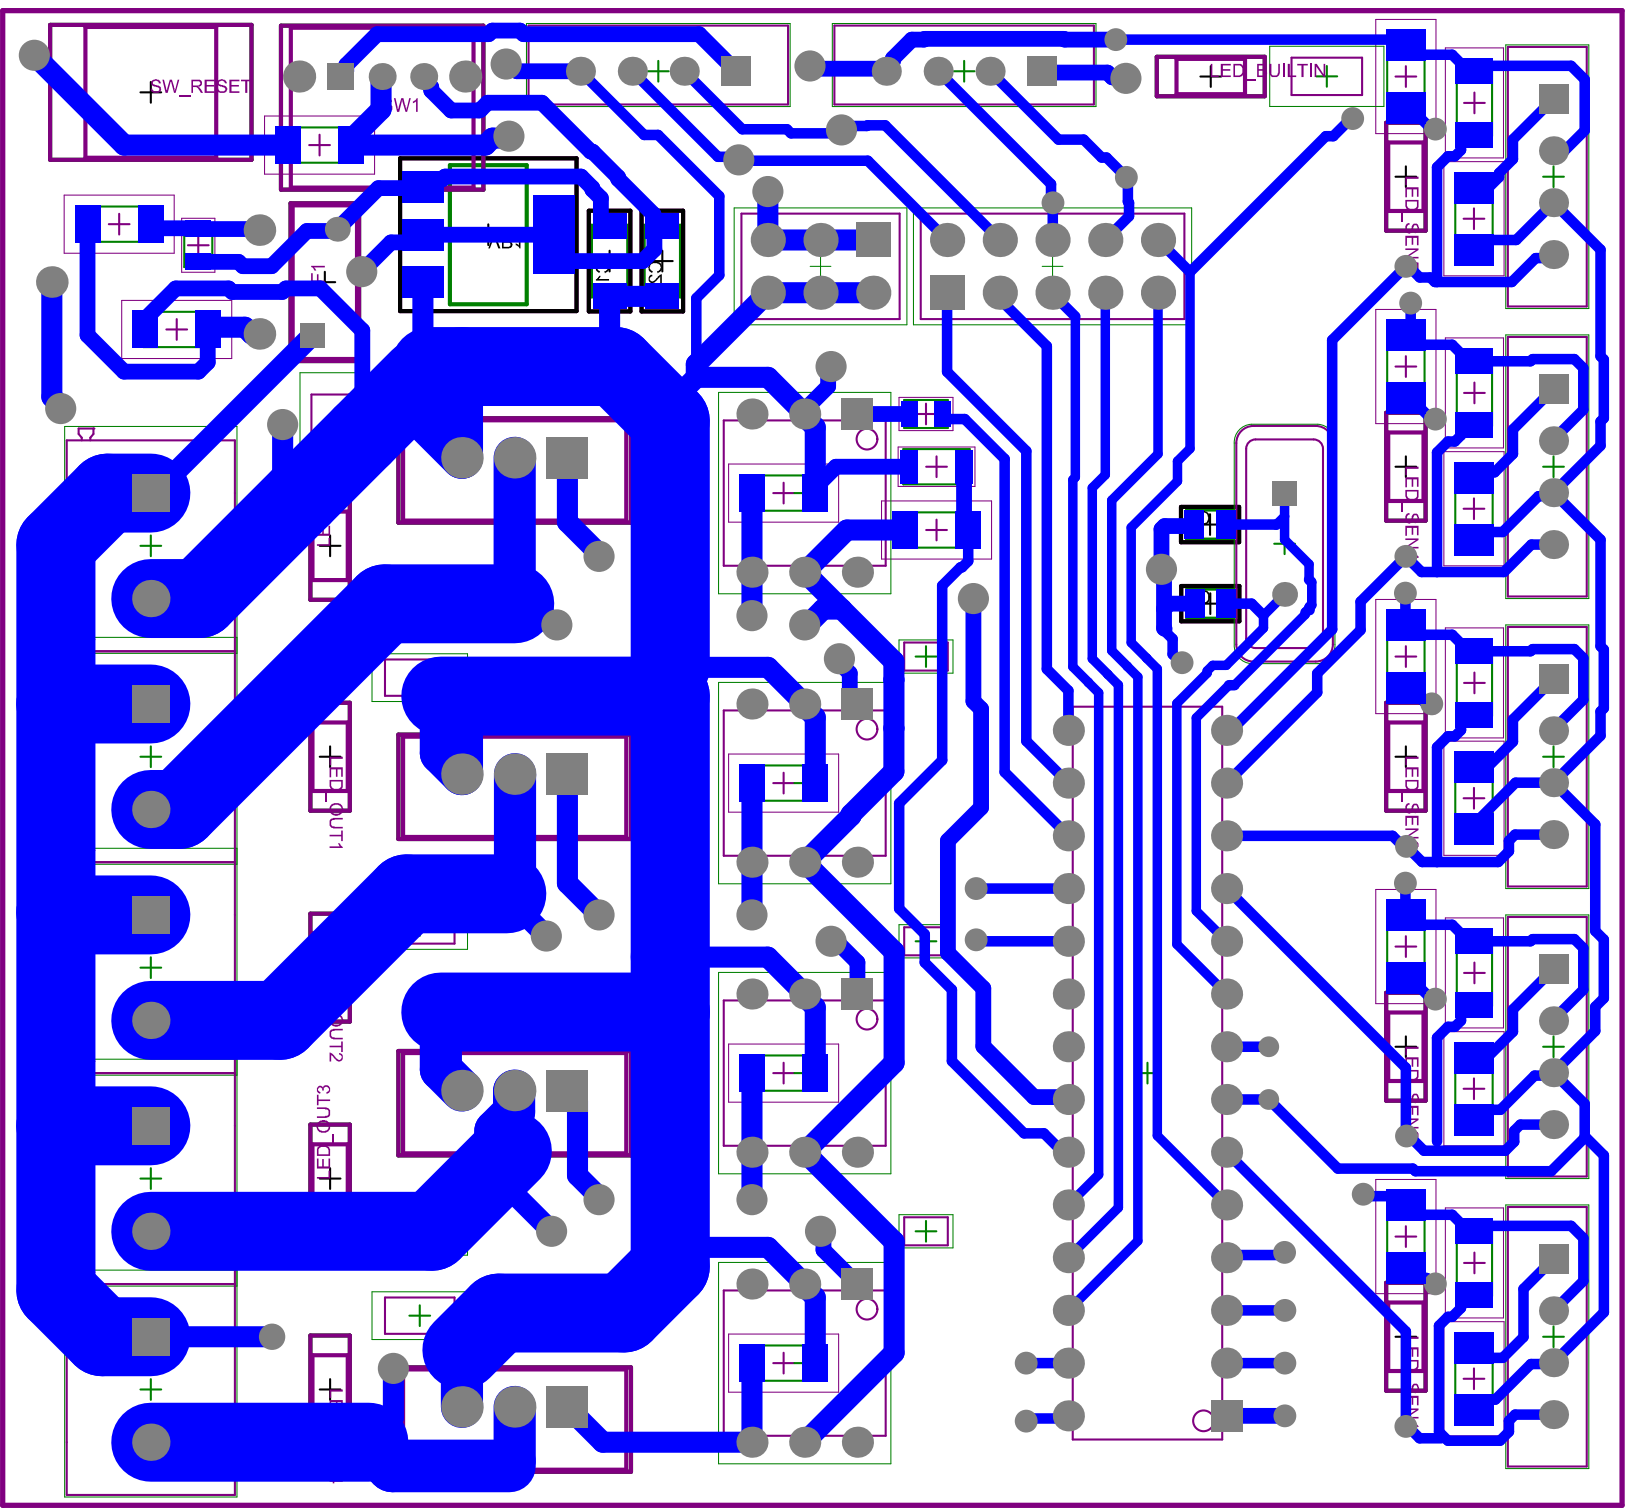
[picture p36: page 3]

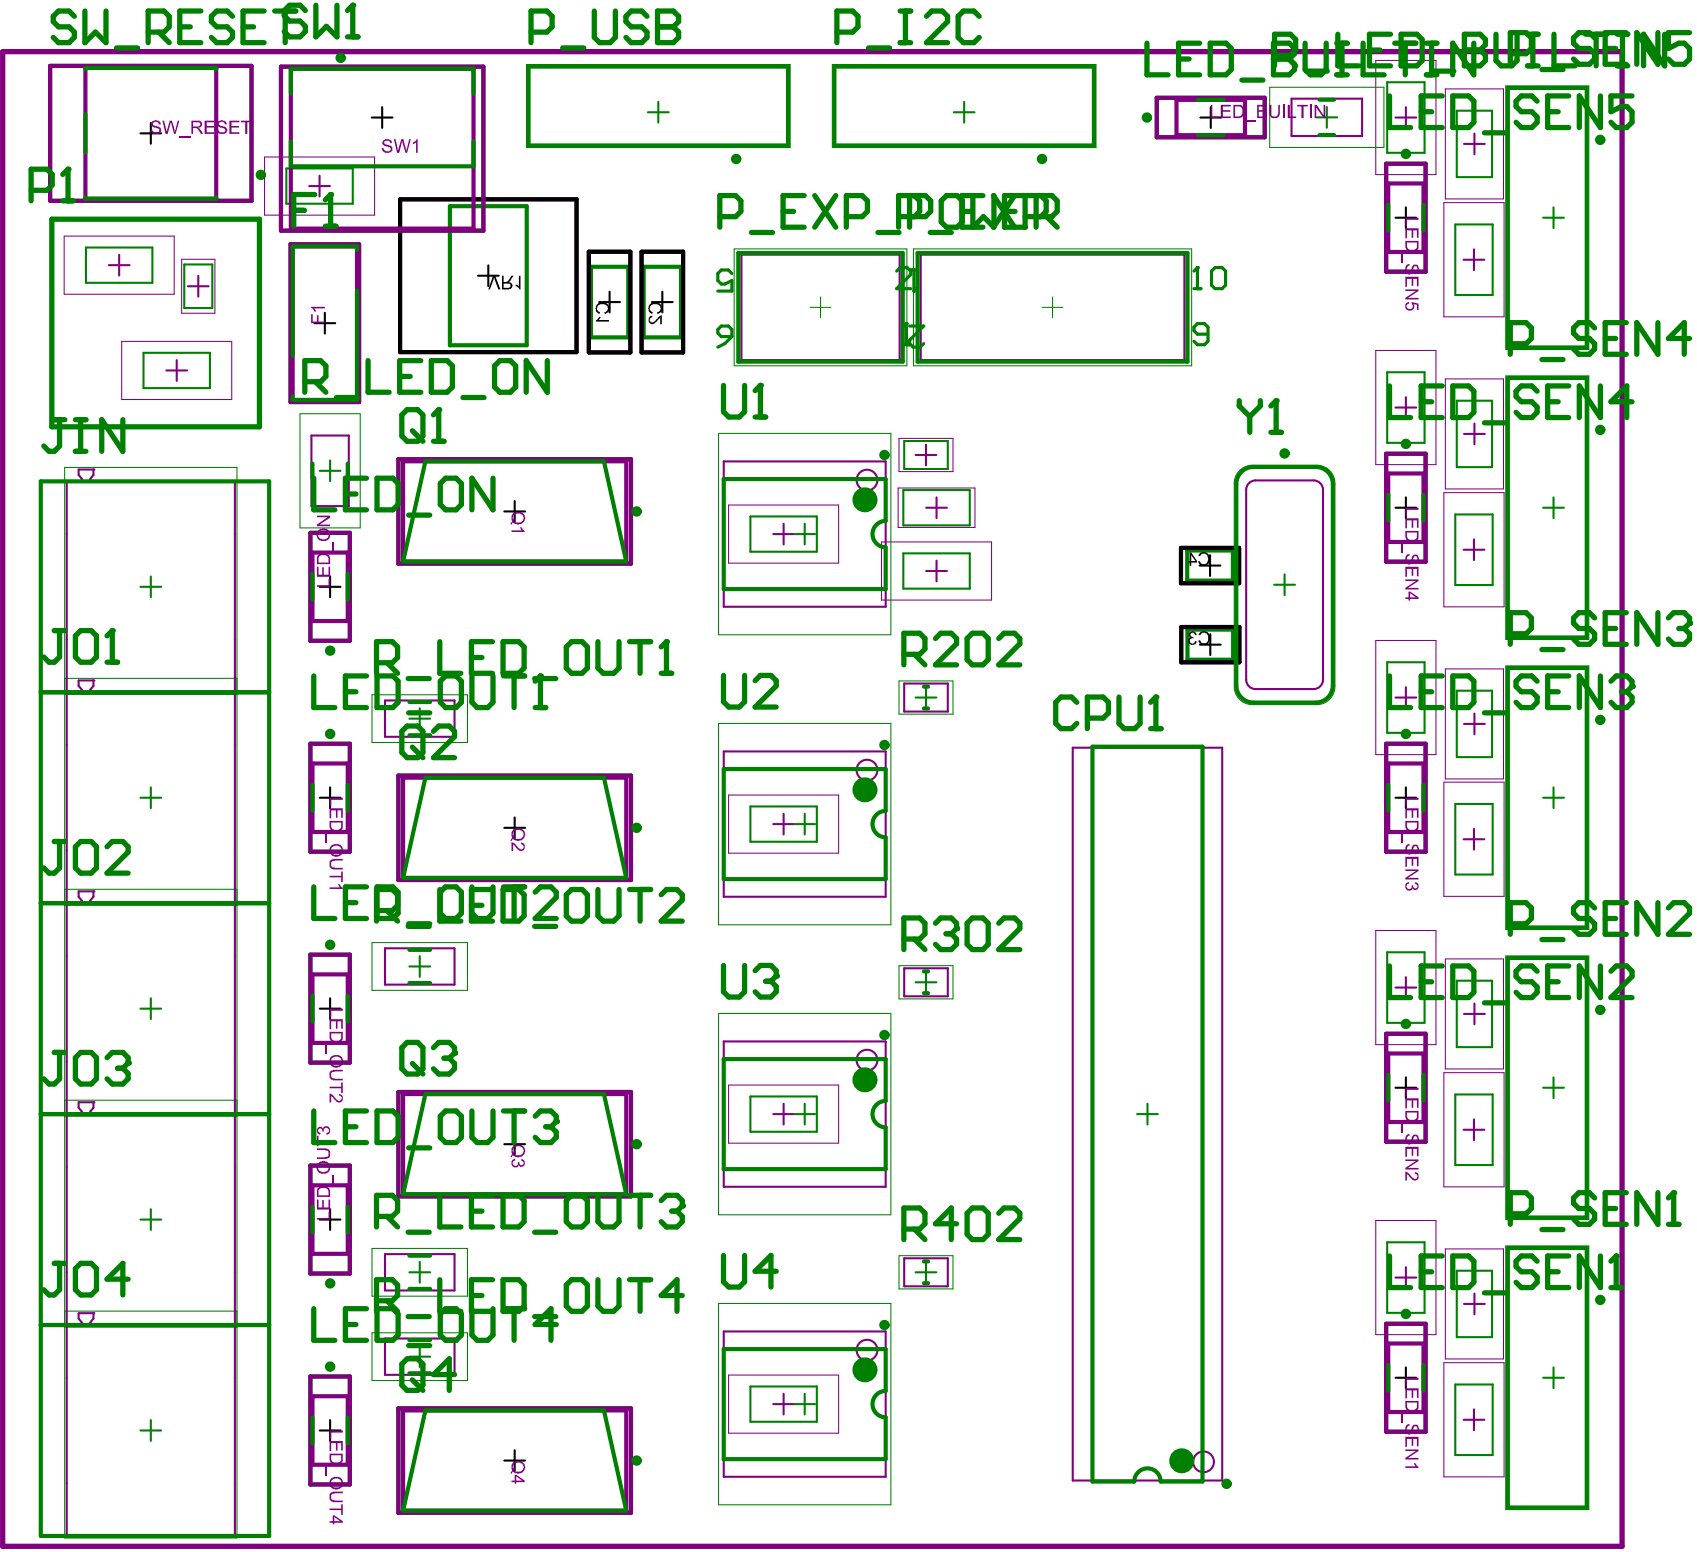
[picture p37: page 4]

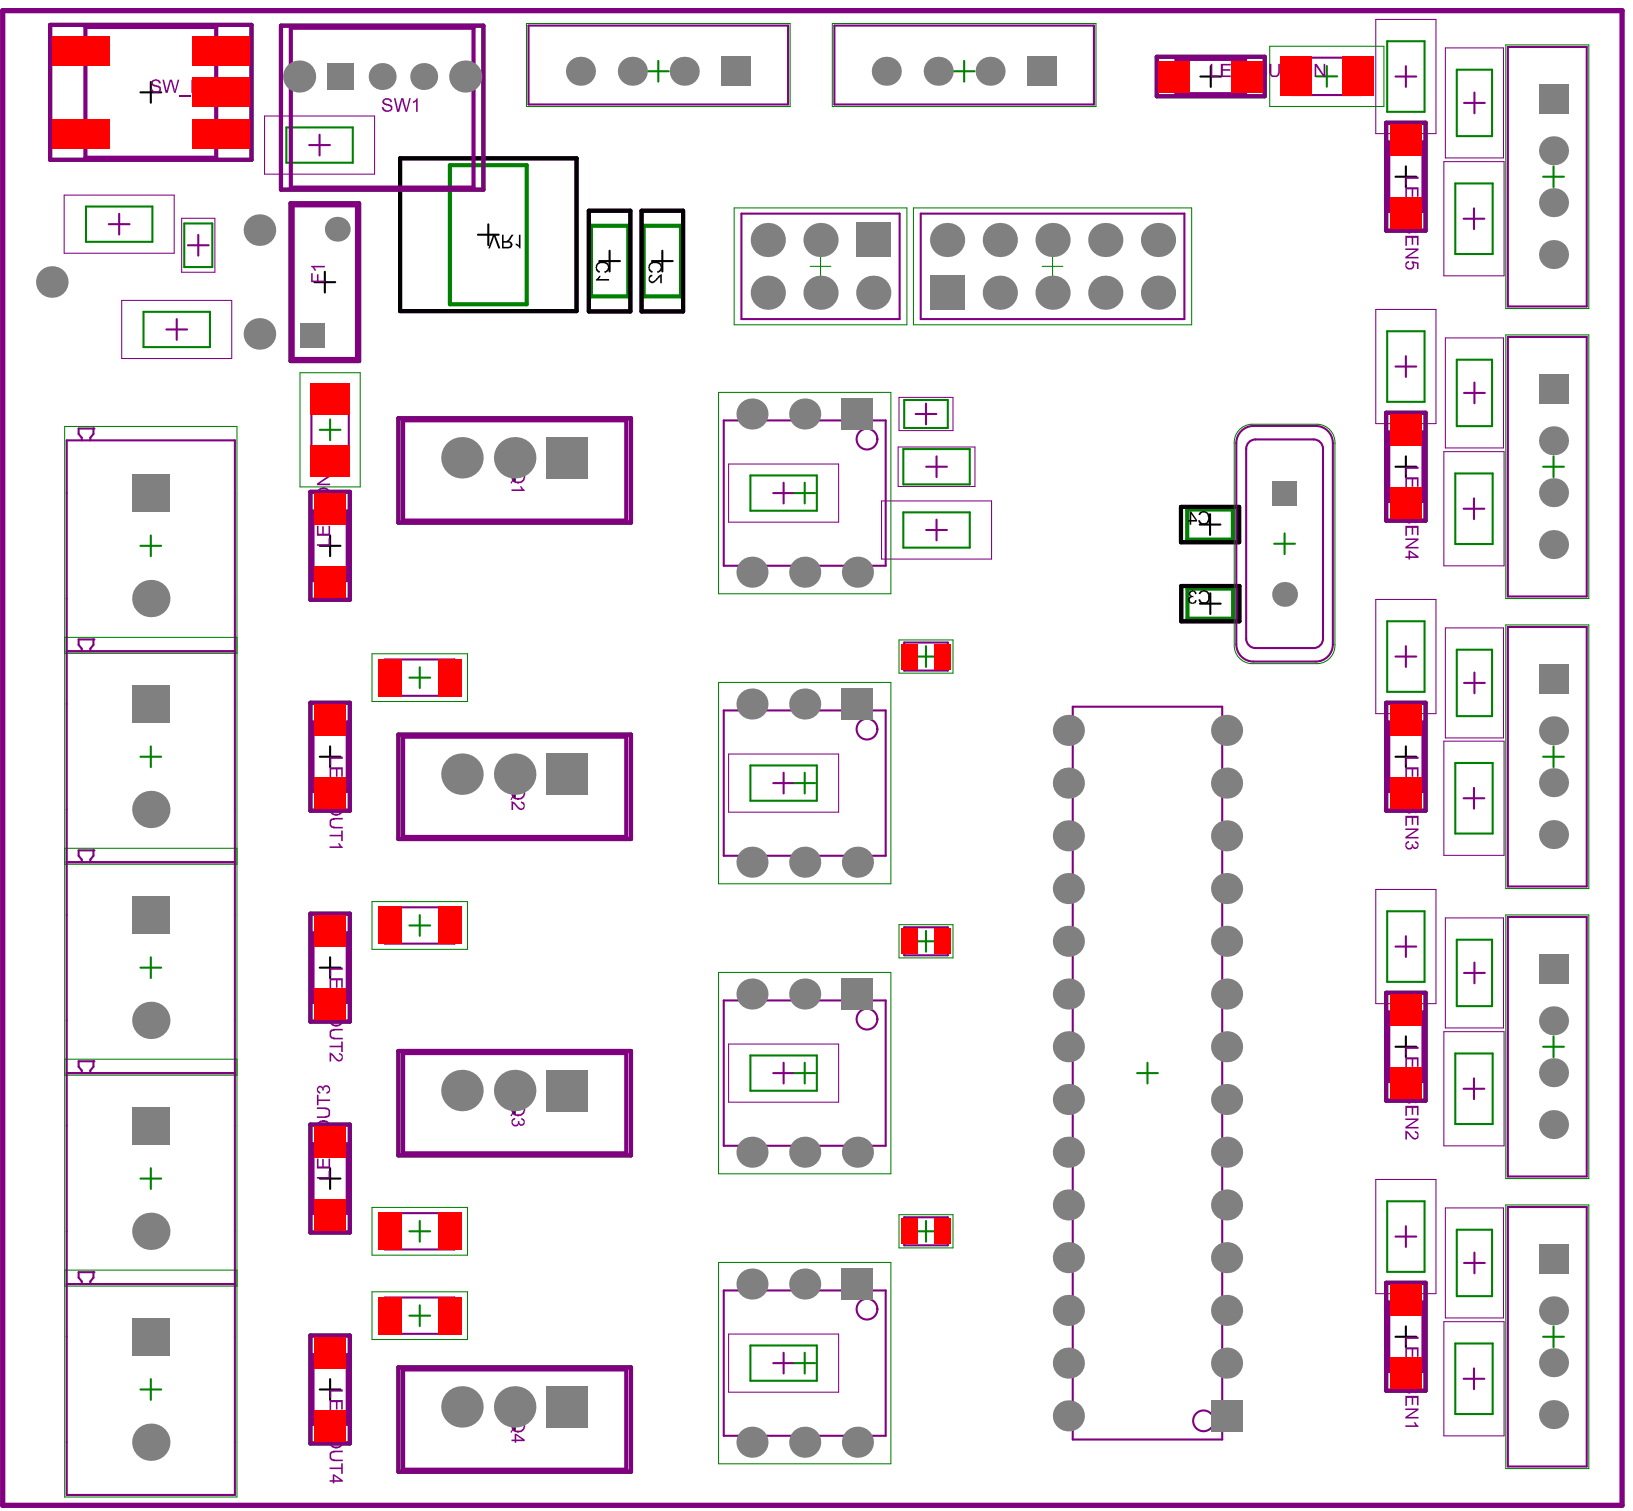
[picture p38: page 5]

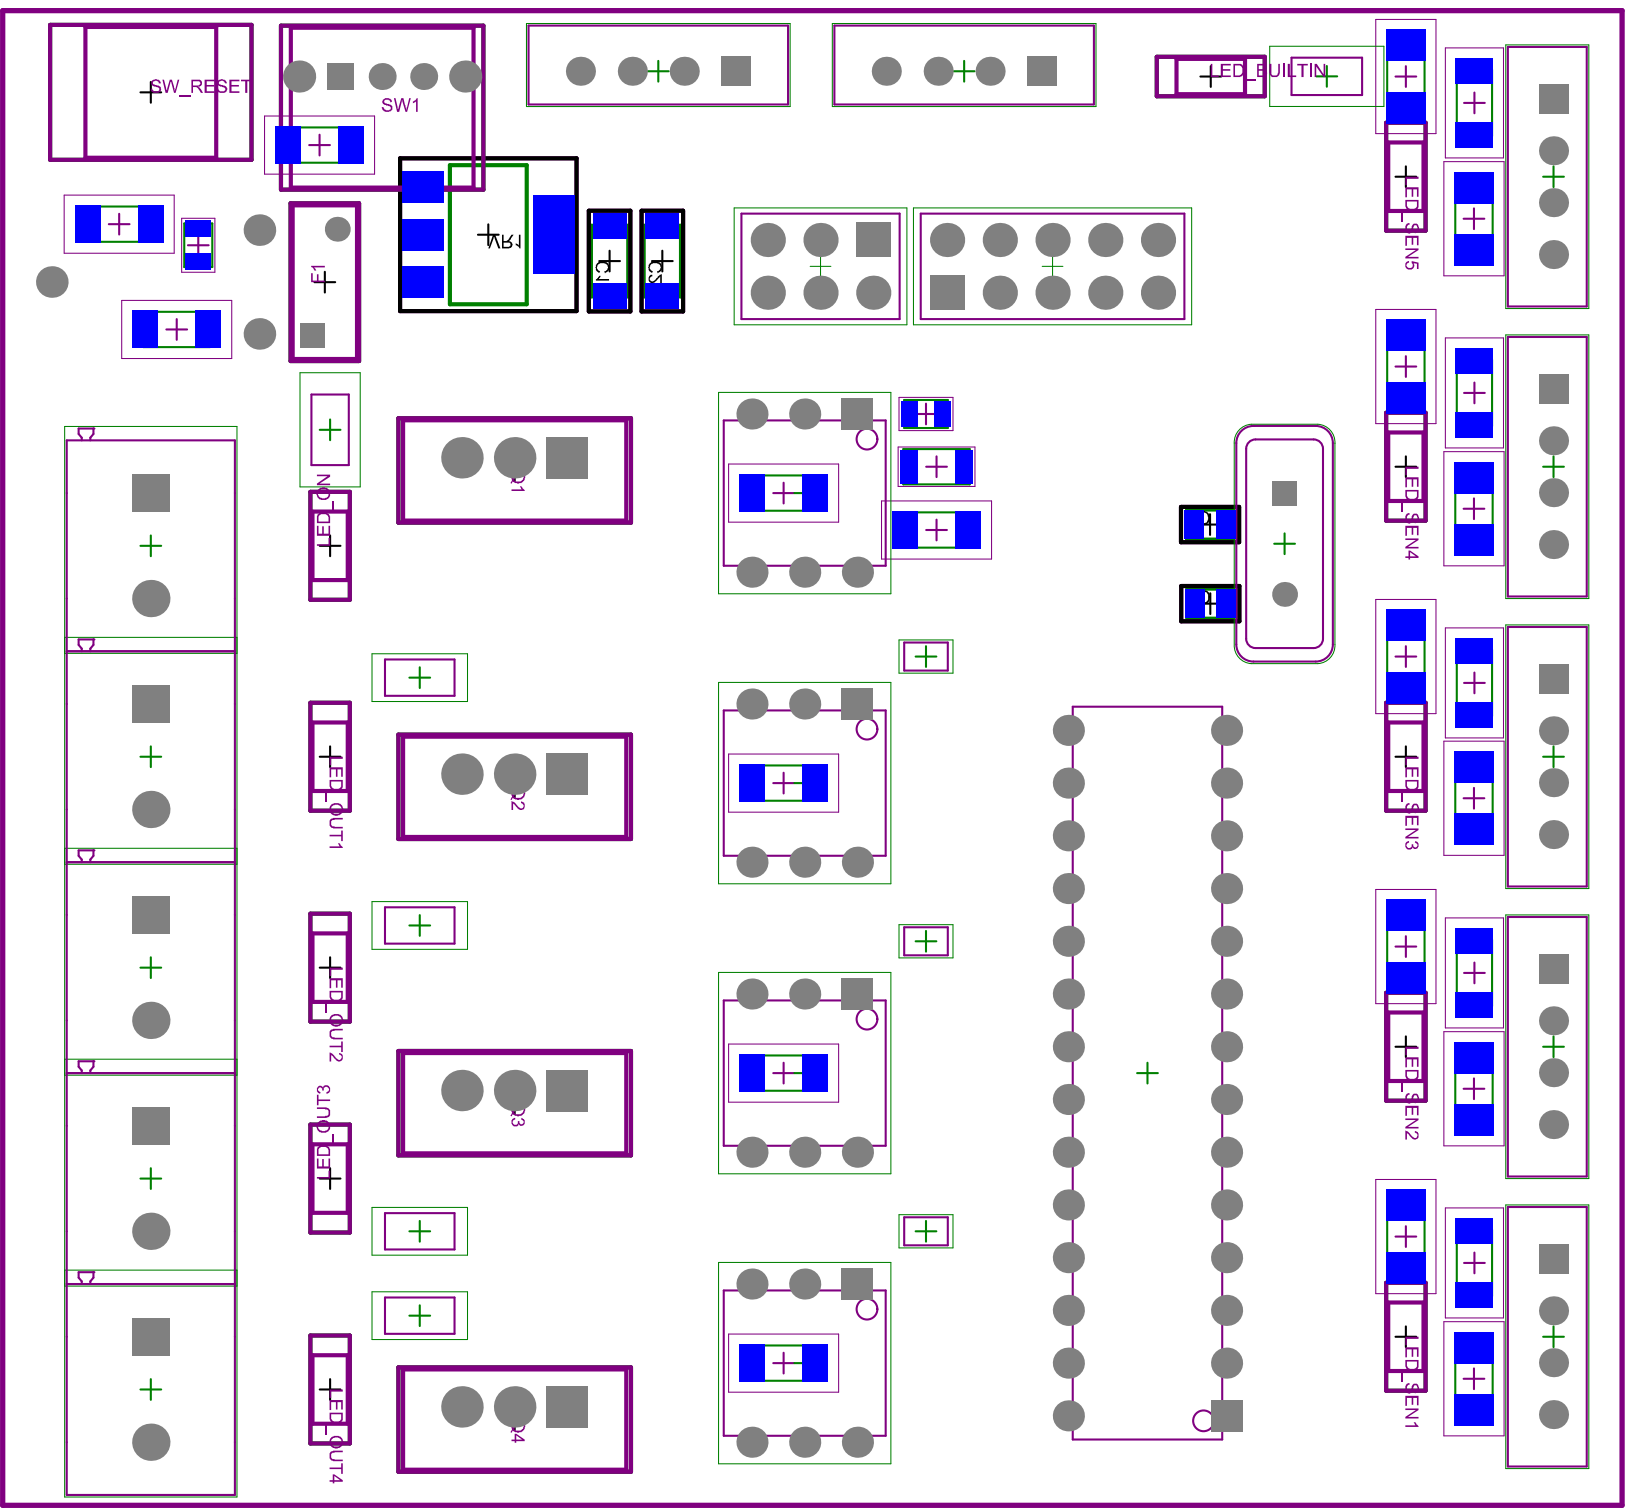
[picture p39: page 6]

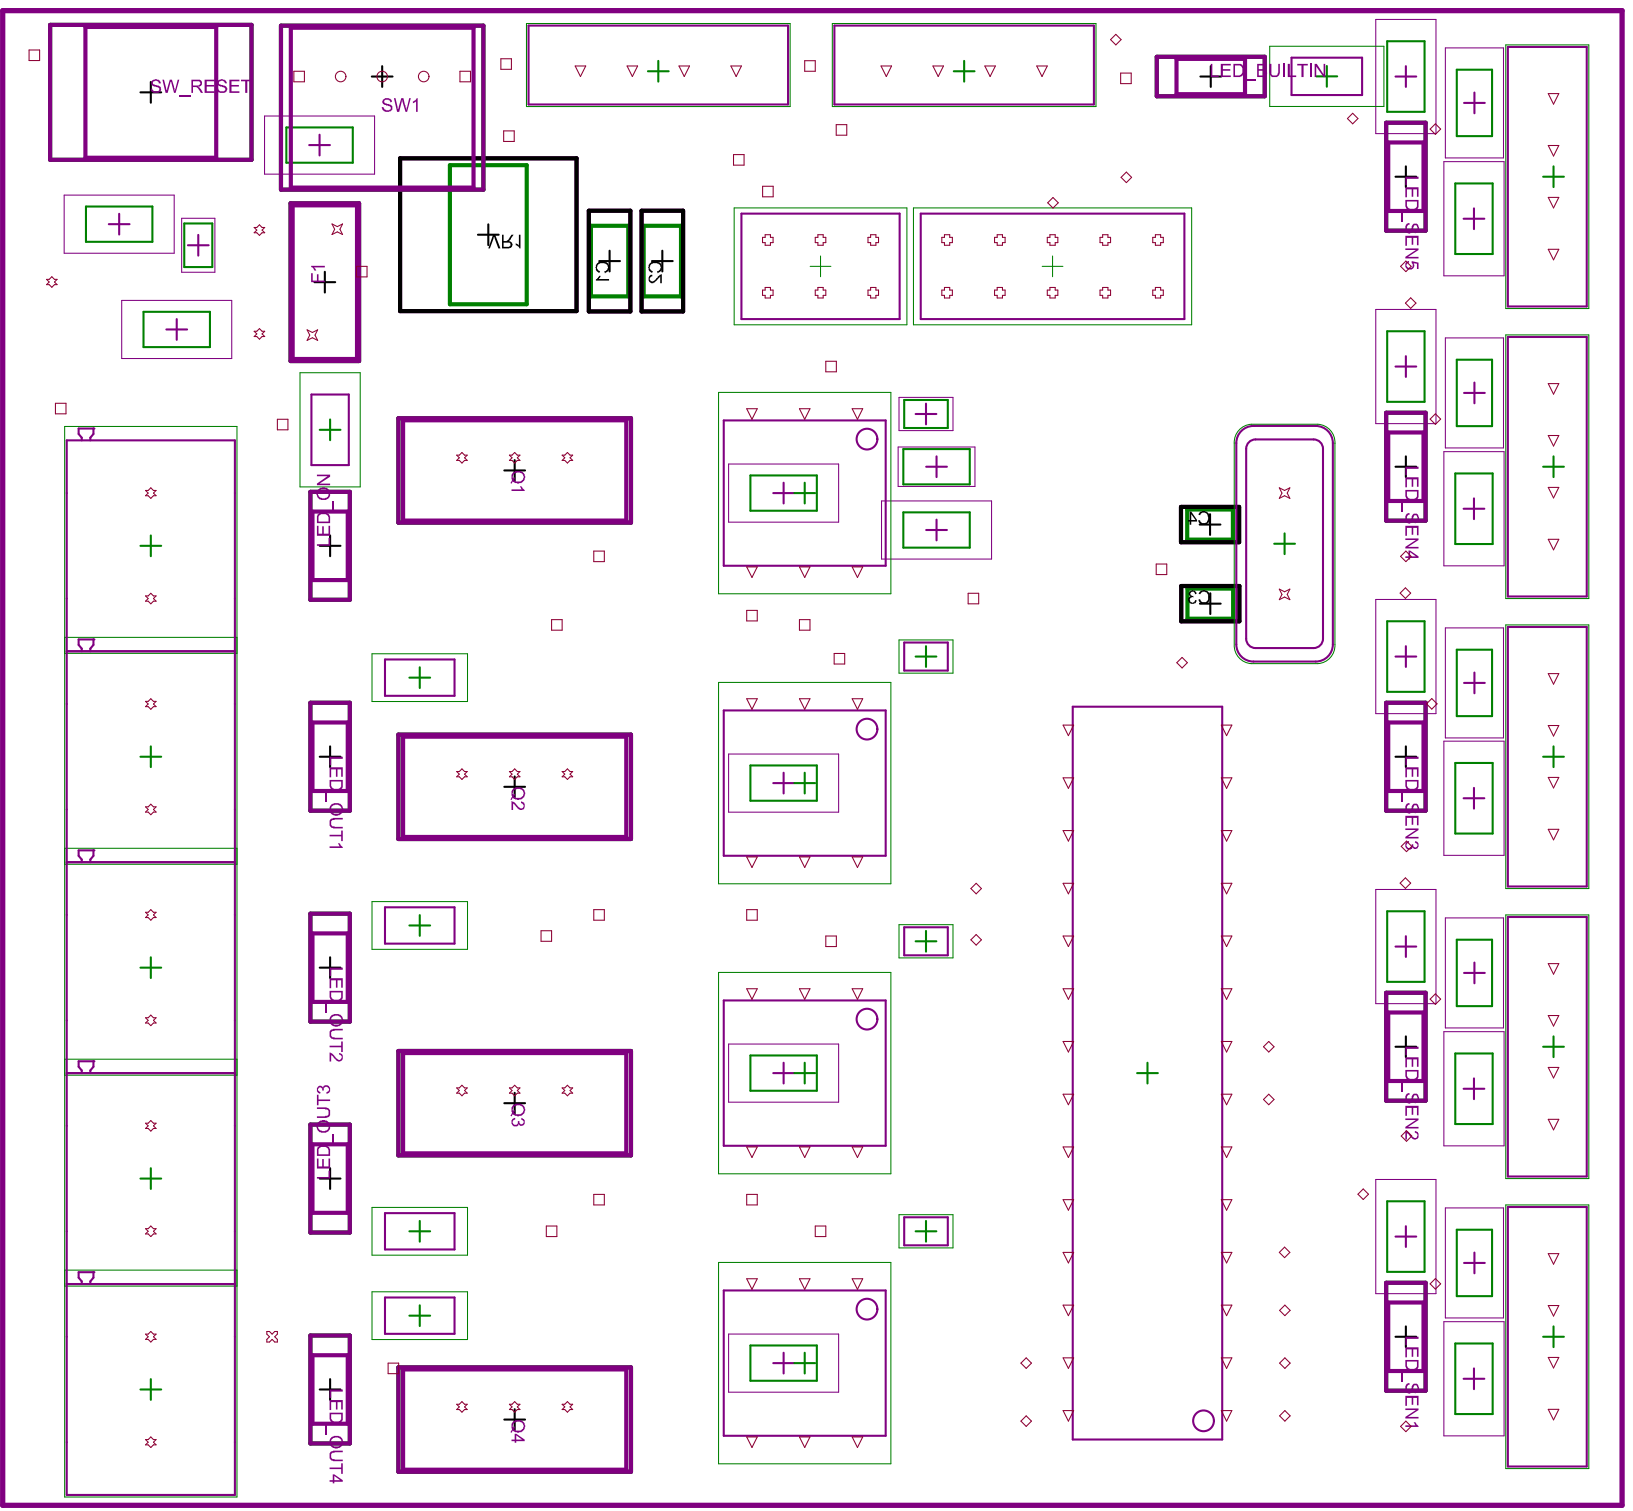
[picture p40: page 7]

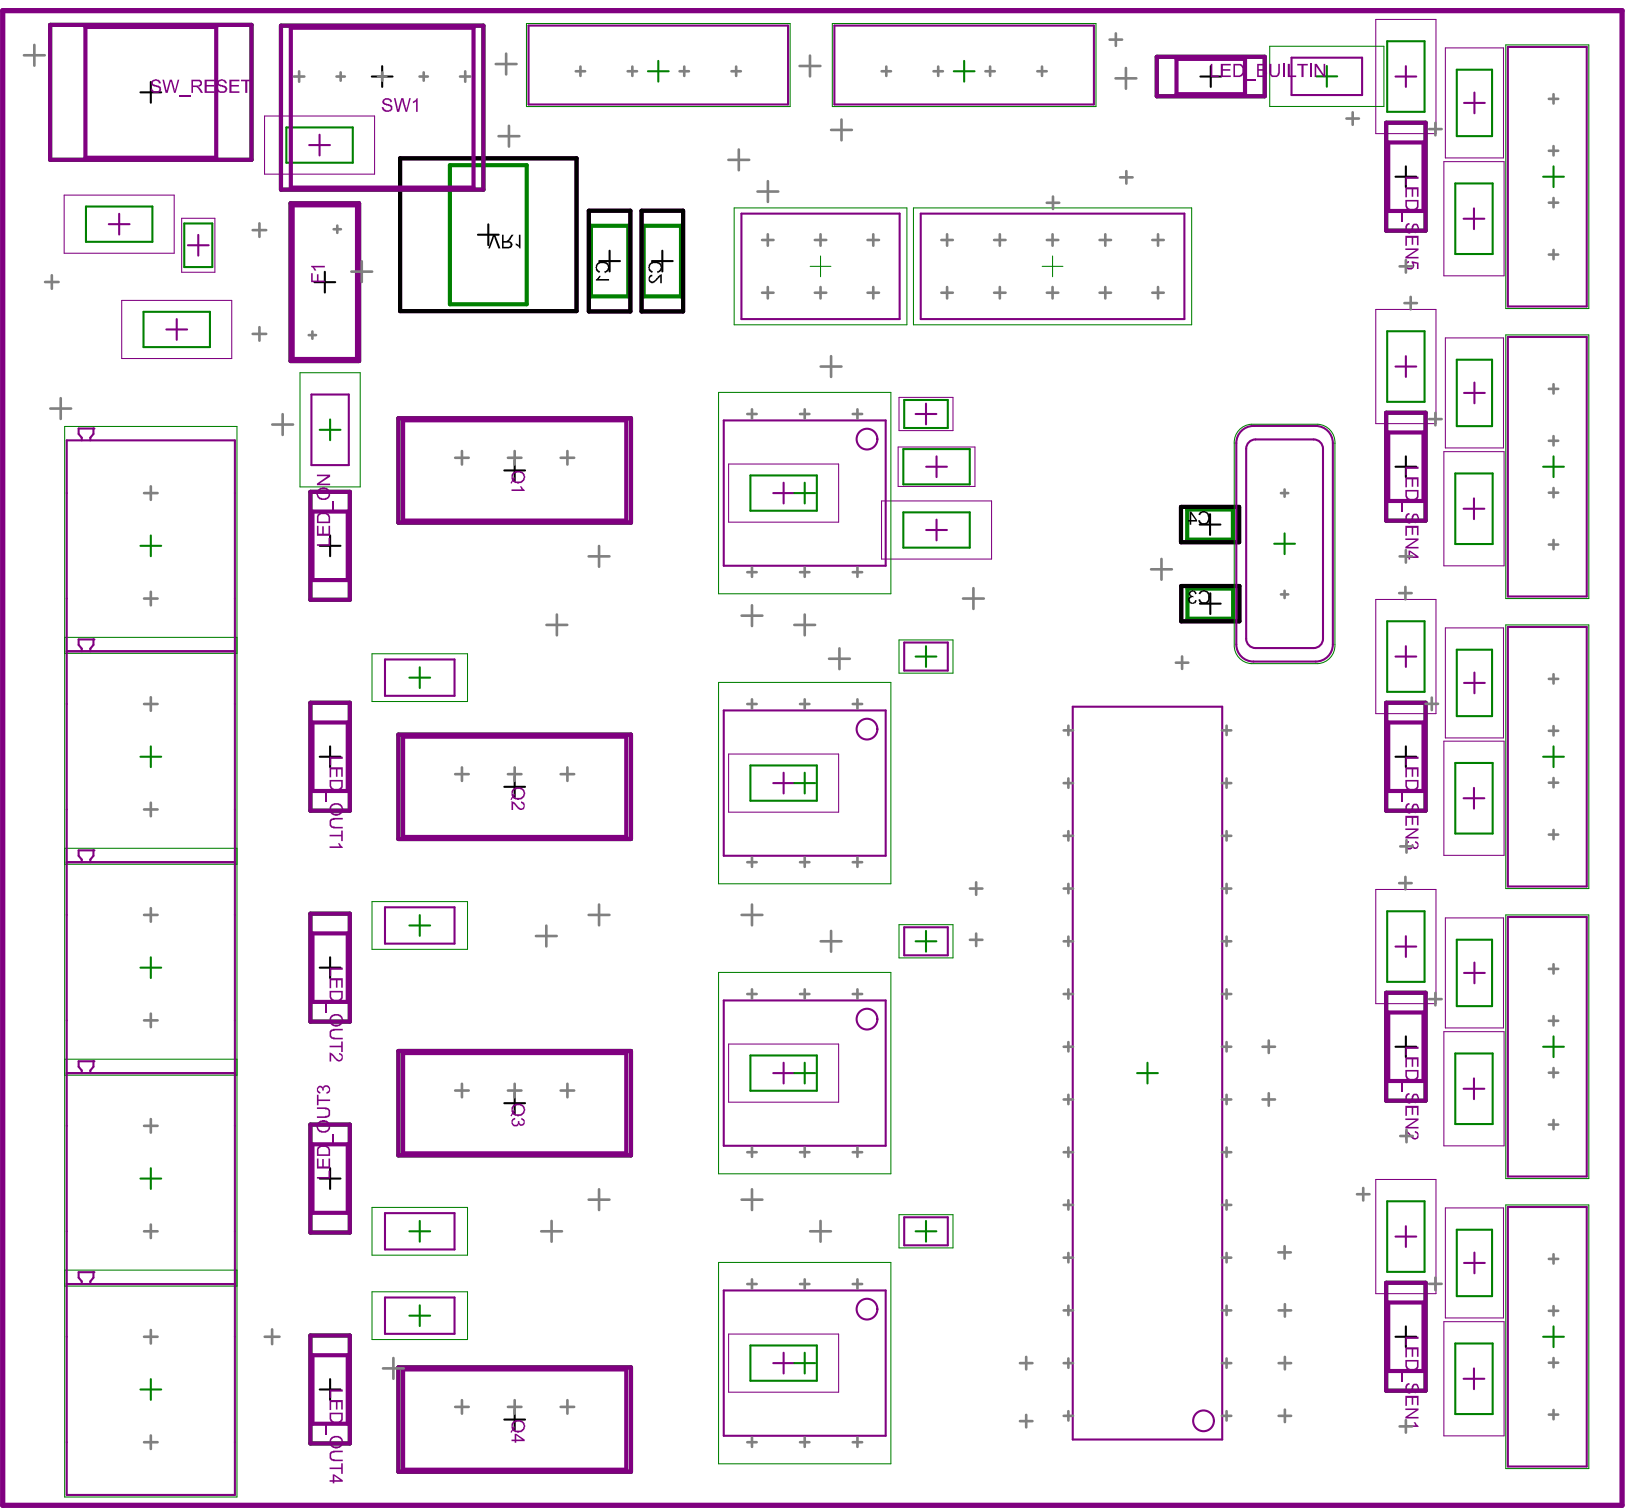
[picture p41: page 8]

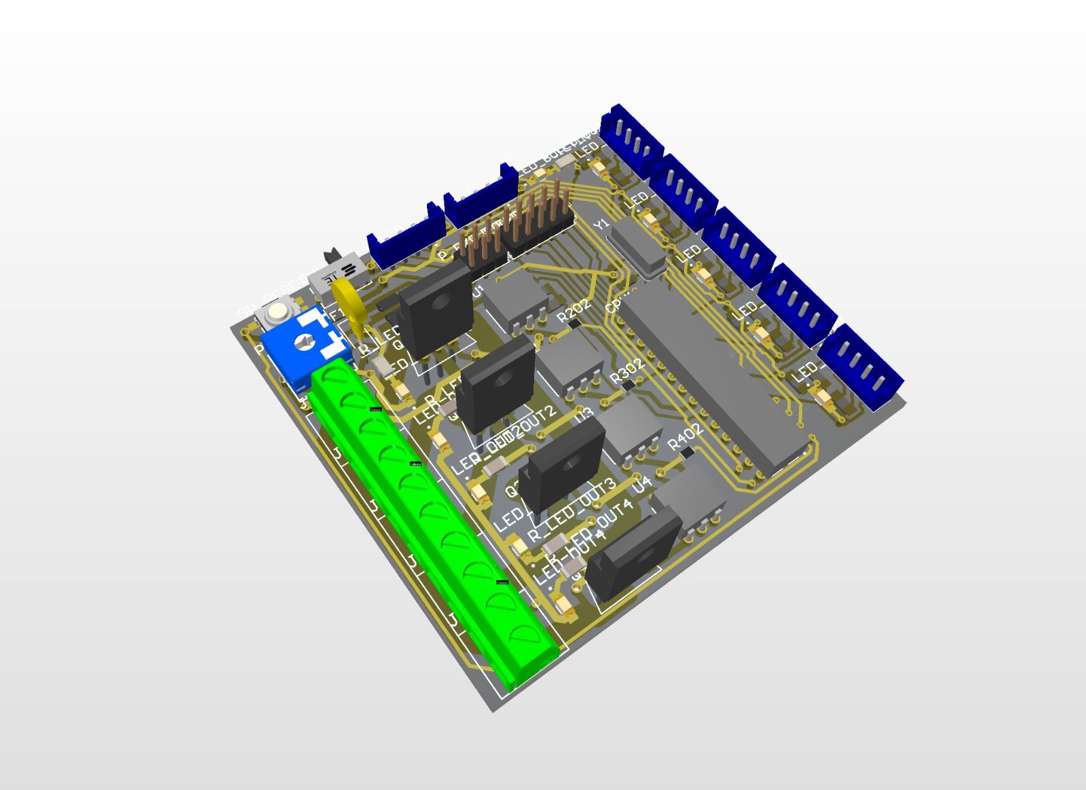
[picture p42: page 9]
