superhasduper/ca-on-electromagnetico/PCB/Coilgun_PDM/Project Outputs for Coilgun_PDM/Job1.PDF

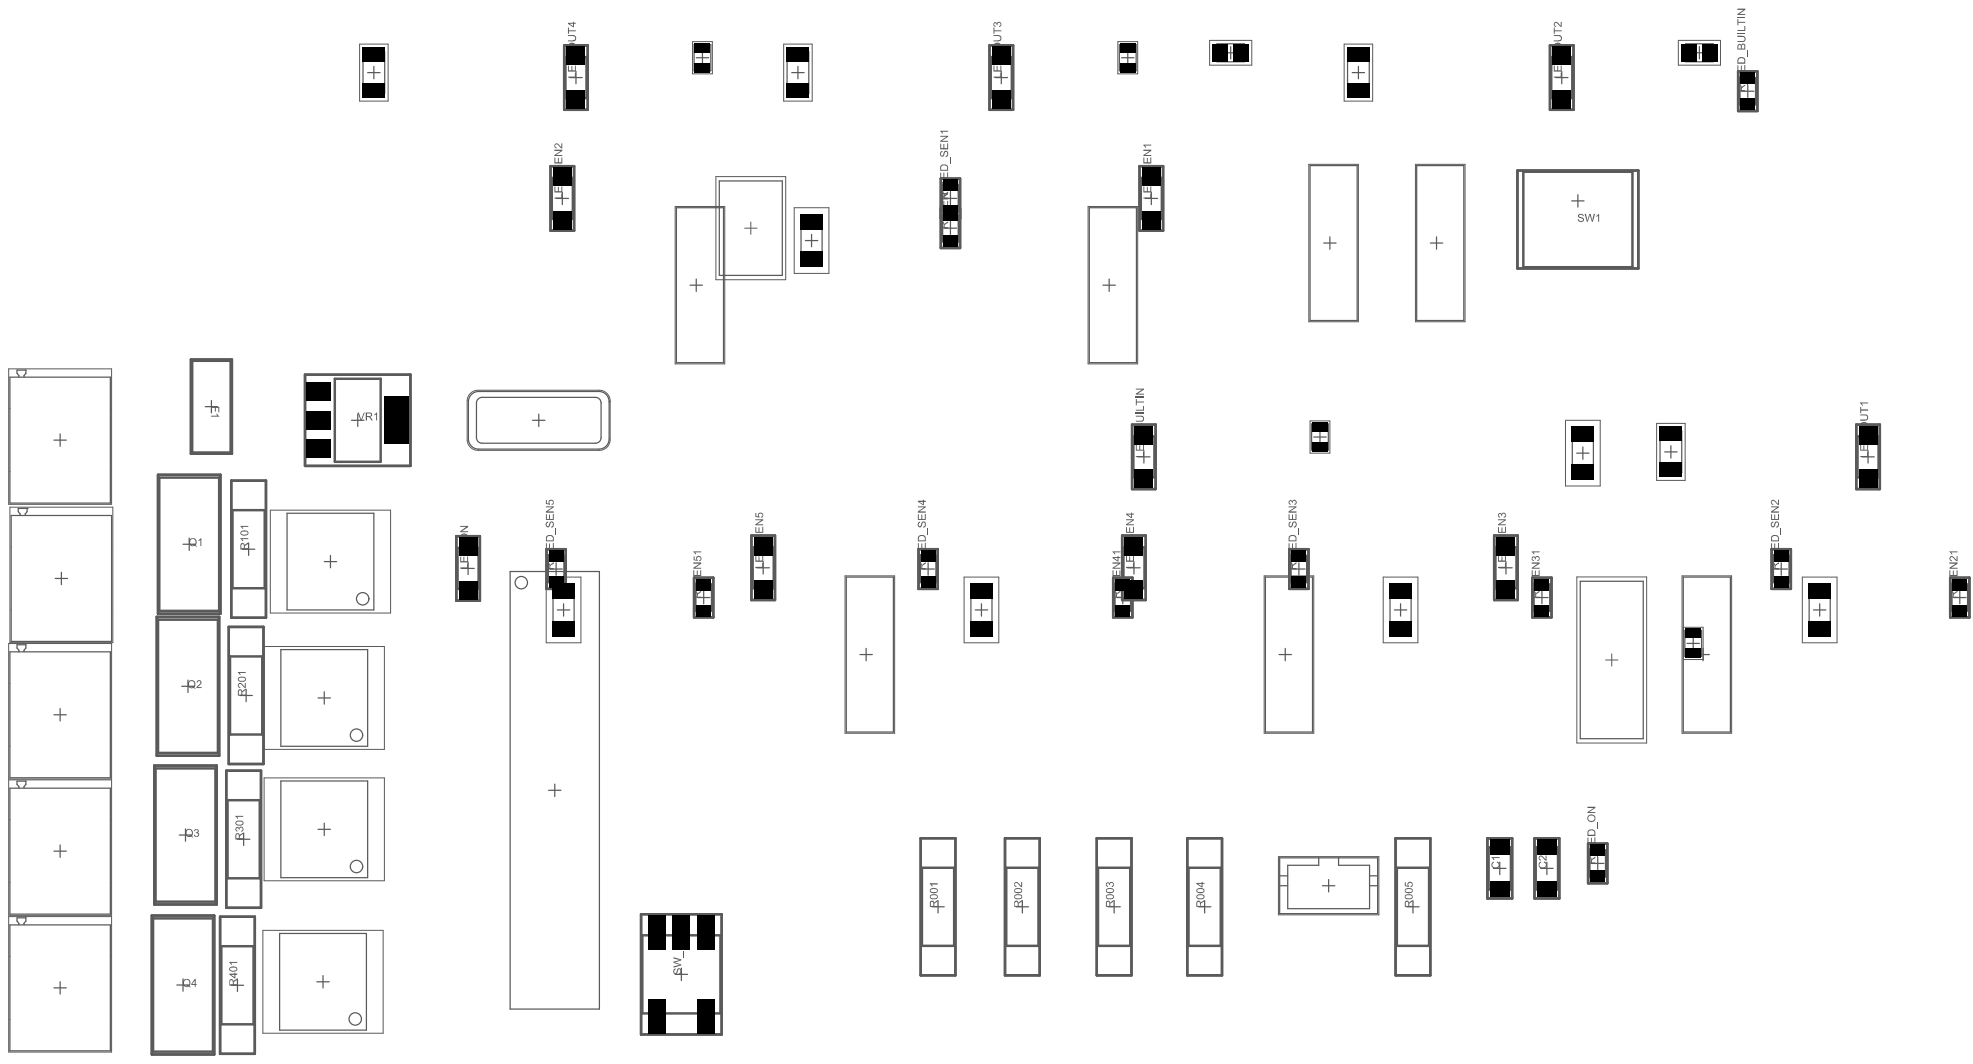
[picture p43: page 1]

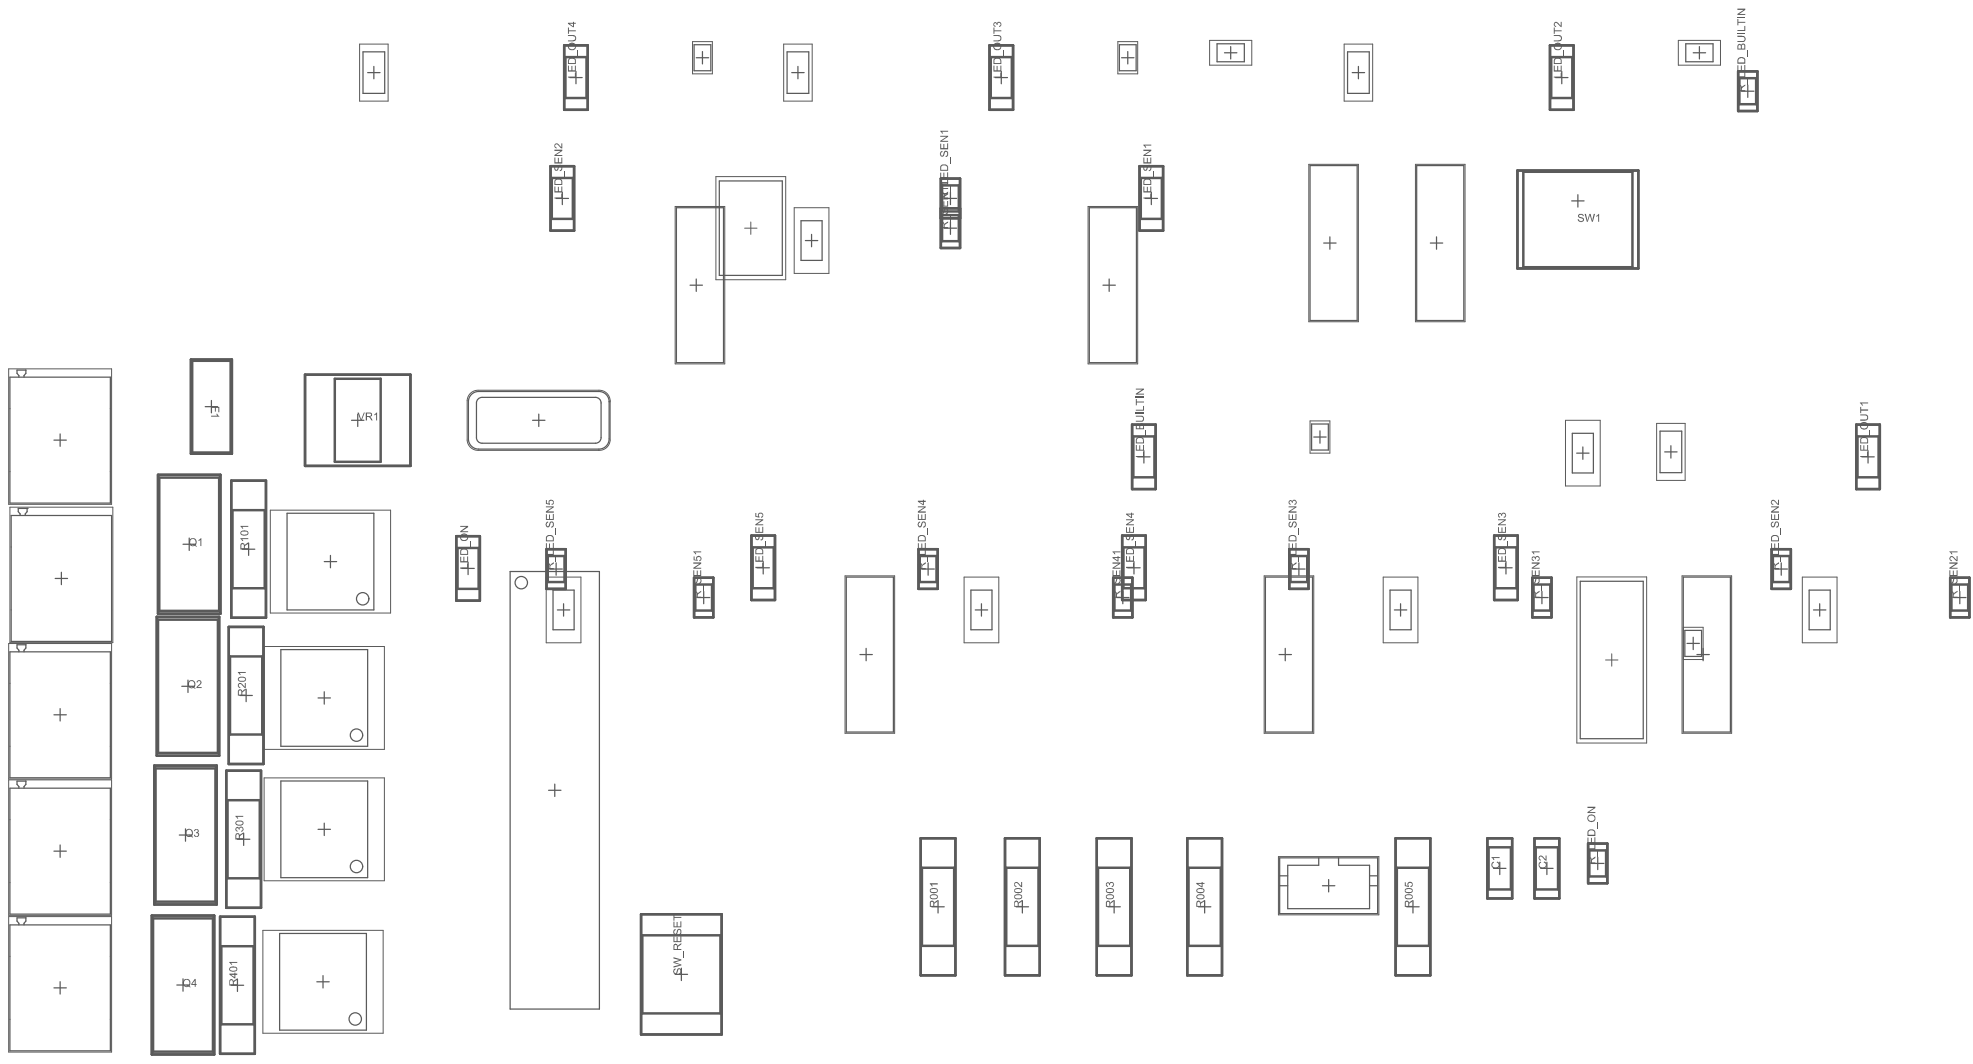
[picture p44: page 2]
