superhasduper/ca-on-electromagnetico/(list of files, drawings)

Other design files:
PCB/archivos altium/PCB_Library.PcbLib
PCB/archivos altium/Schematic_Library.SchLib
PCB/CoilGun_PCB.PcbDoc
PCB/Coilgun_PDM/Coilgun_PDM.PrjPcb
PCB/CoilGun_Schematic.SchDoc
